Hemisphere-Project/FarAway/Arduino/Full-ESP32-pio/src/Pinout.txt

MOTOR
PUL --- 13
DIR --- 12
EN --- 14

RED LED
Data --- 27

I2C
SCL --- 33
SDA --- 32

SK
Data --- 4

AUDIO
PWM --- 22
