Hemisphere-Project/FarAway/Plans/Casing/Débit.rtf

Panneau CP peuplier 2520 x 1850 ép 15mm
—> 2 panneaux

Bas
3224 x 694
2520 x 694 + 704 x 694

Haut
3224 x 694
2520 x 694 + 704 x 694

Left
3224 x 400
2520 x 400 + 704 x 400

Right
3224 x 400
2520 x 400 + 704 x 400

Av
610 x 400

Arr
610 x 400

TASSEAUX

3224 —4 (L,R)
280 — 12 (L,R,Av,Arr)
610 — 4 (Av,Arr)
490 — 4 (Av,Arr,Top)
3140 — 2 (Top)

Tasseau raboté Pin 27 x 60 L4,8m
—> 6 Tasseaux
