Hemisphere-Project/FarAway/Plans_Cablage/Cablage.pdf

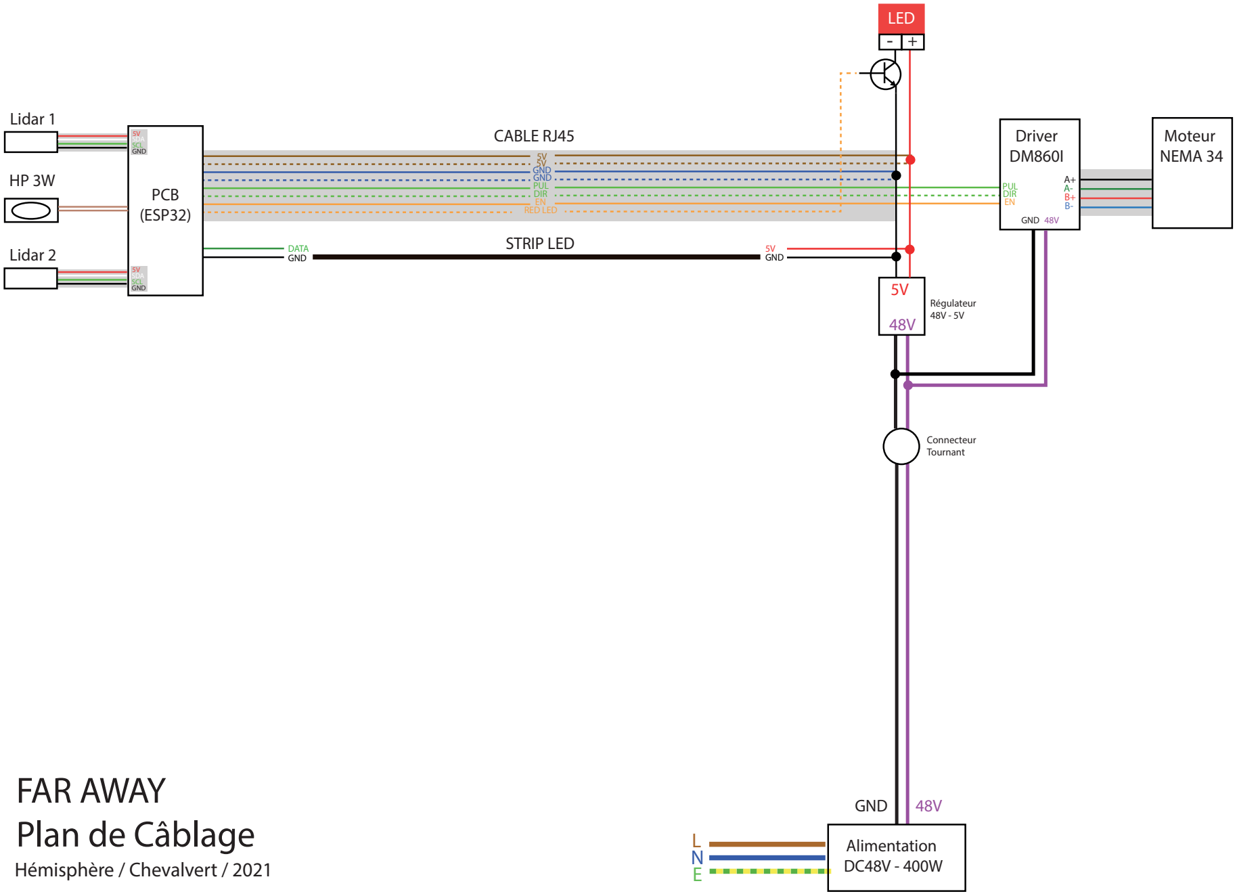
[picture p1: figure]
GND; GND DATA; 5V GND; GND PUL DIR EN RED LED; STRIP LED; Régulateur 48V - 5V; Connecteur Tournant; Driver DM860I; LED; Alimentation DC48V - 400W; Moteur NEMA 34; GND 48V; CABLE RJ45; FAR AWAY Plan de Câblage; Hémisphère / Chevalvert / 2021; Lidar 1; PCB (ESP32); PUL DIR EN; 5V SDA SCL GND; Lidar 2; SDA SCL GND
