Hemisphere-Project/FarAway/Docs/Far Away V2.pdf

Far away,

# Constellation 2021

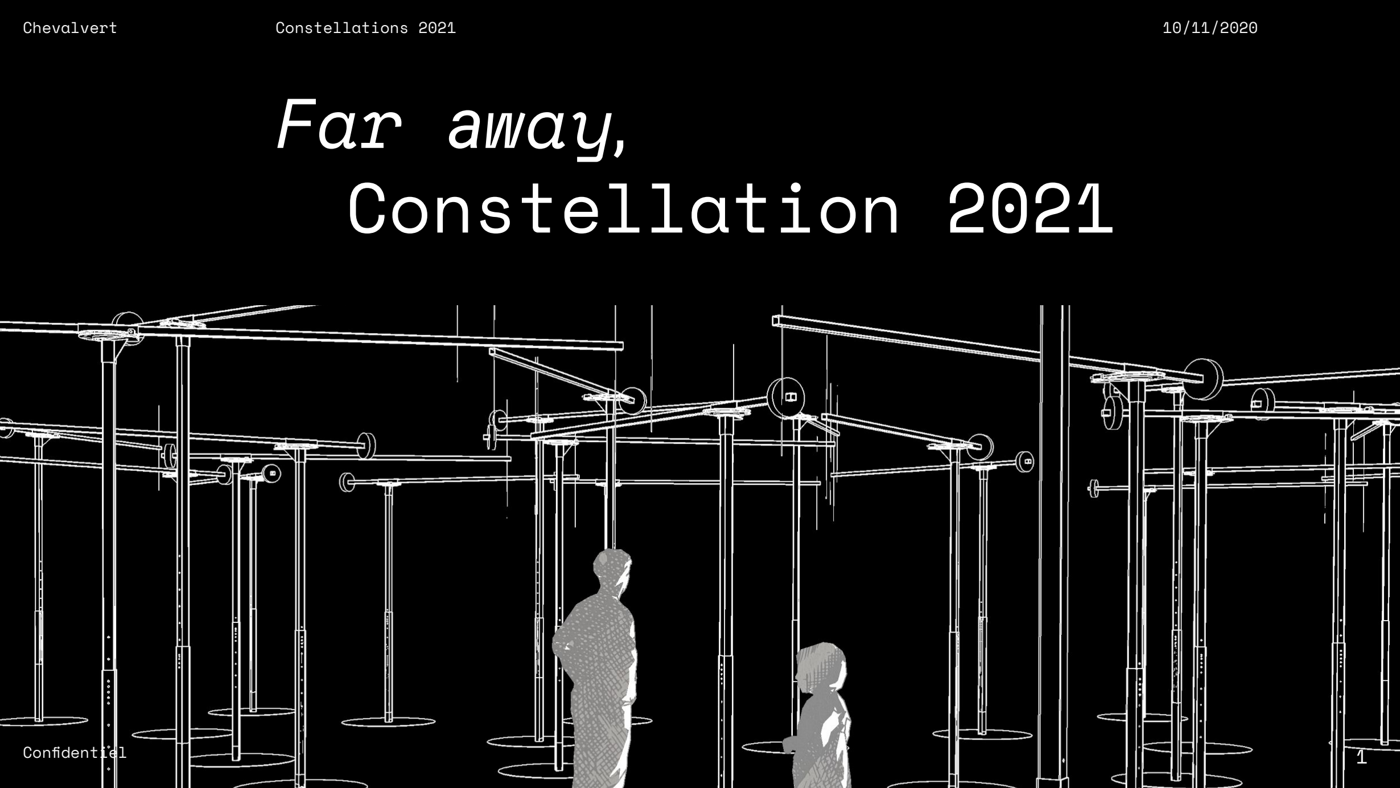
[picture p2: page 1]

10/11/2020

Confidentiel | 1
Chevalvert | Constellations 2021

# 1. Ré-enchanter la pointe Fabert en imaginant une installation

phare.

# 2. Un réseau lumineux inscrit entre deux des bras de la Moselle, aux

flux de l’eau et de la végétation.
3. Un signe lumière en mouvement,

# vivant, impulsé par l’activité des visiteurs et transmis de phare en

phare.

Chevalvert | Constellations 2021 | 10/11/2020

## Références et inspirations

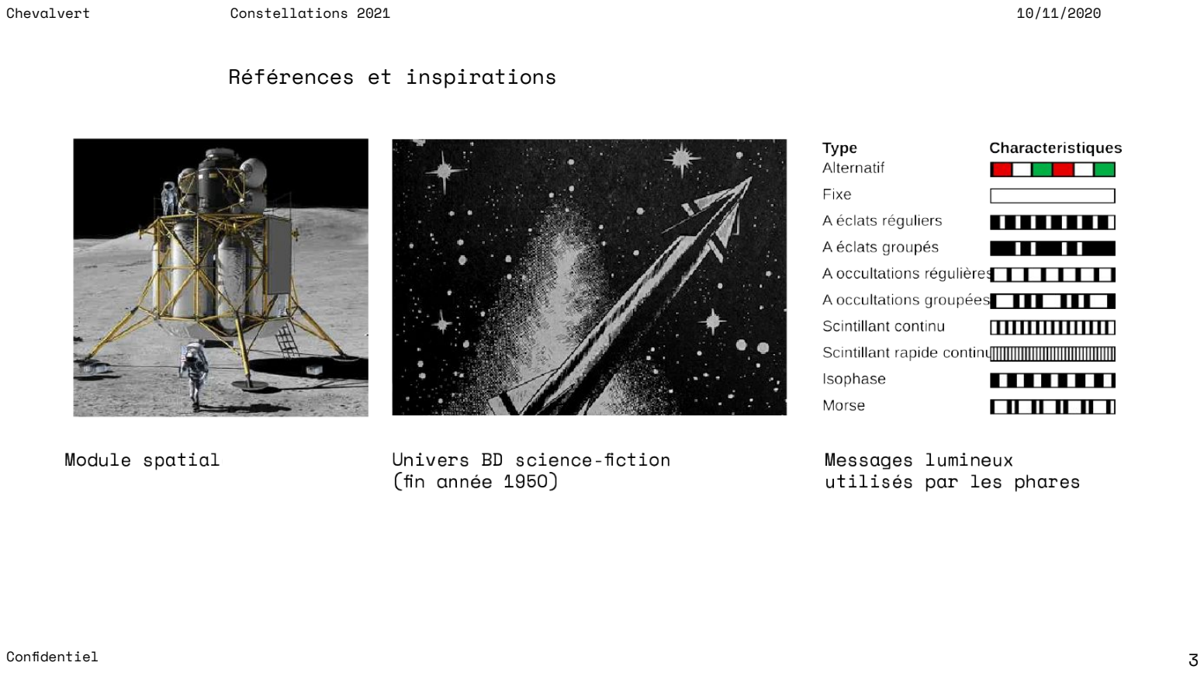
[picture p3: page 3]
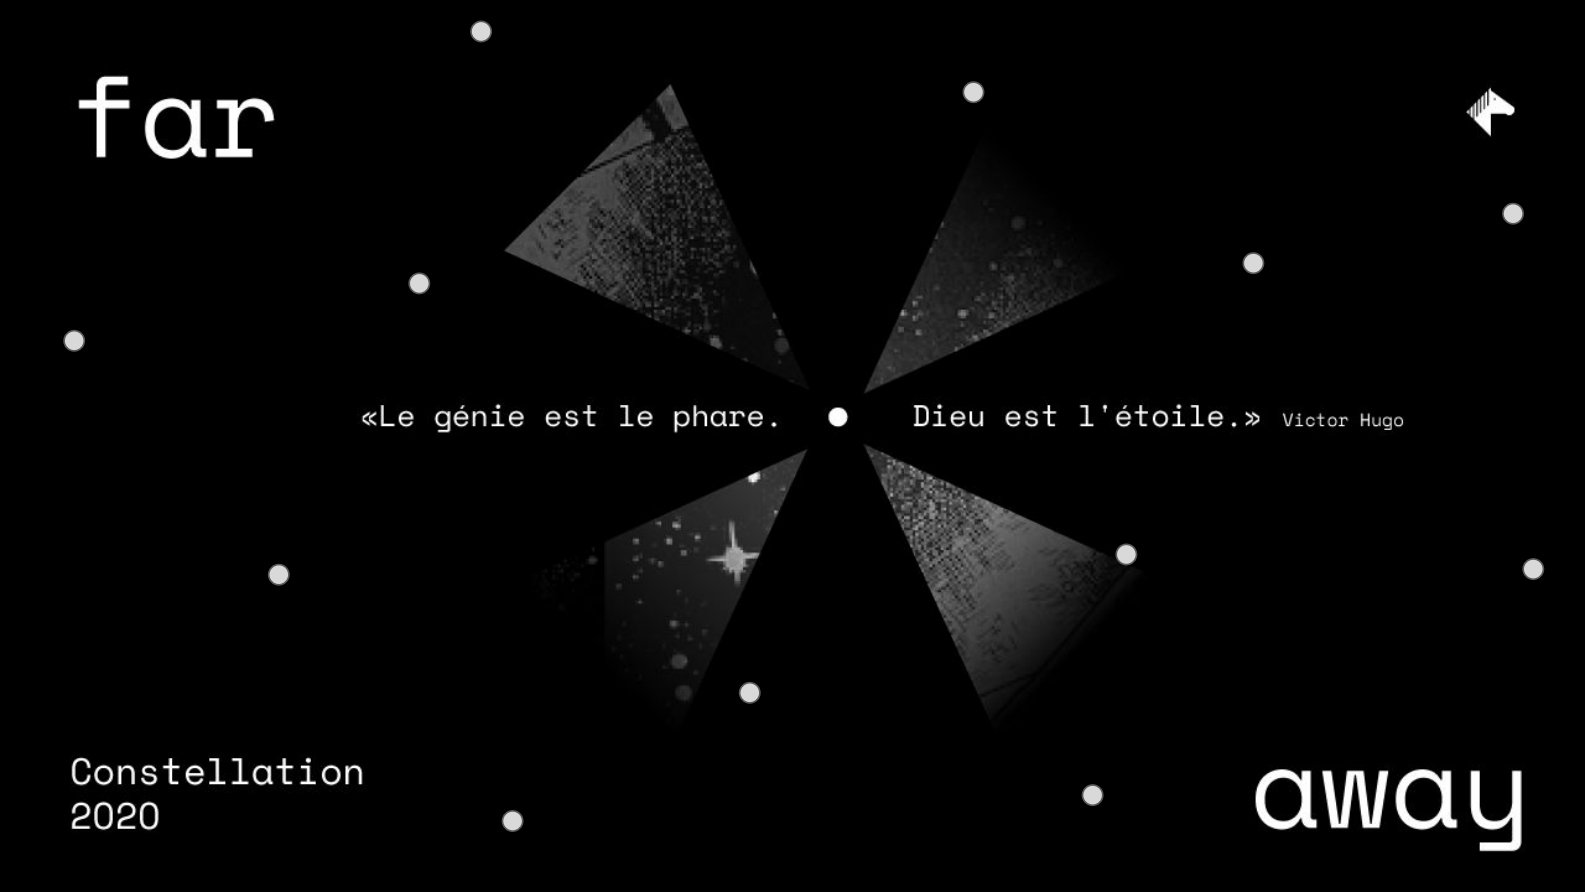
[picture p4: page 4]

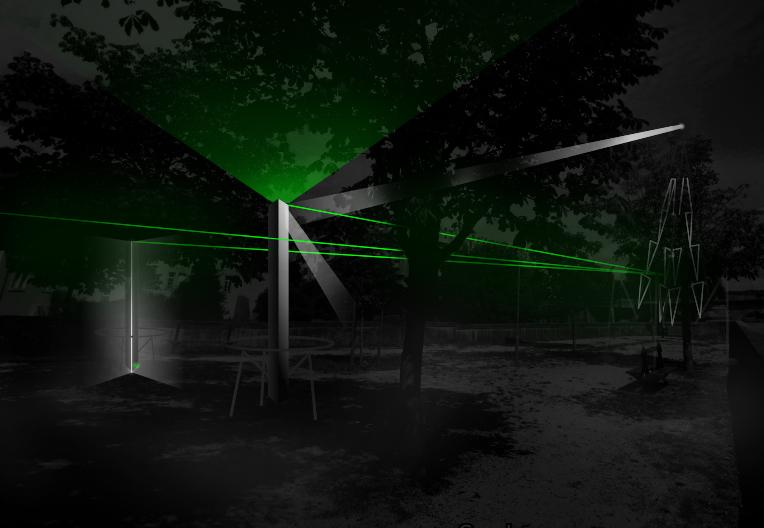
[picture p5: figure]

Version proposée
à l’origine.

## Far Away est une installation contemplative et immersive

autour des notions d’espace, de temps et de lumière.

L’installation se compose d’un module phare multiplié,

## construisant un réseau au sein duquel des signaux lumineux

naissent, se déplacent et meurent.

## La présence du visiteur éveille le phare qui se met à produire de la lumière et à tourner, contactant ainsi ses voisins les plus proches, propageant à la fois son éveil et

son signal lumineux.

## Ce signal ne vit que dans le mouvement, se déplaçant entre

les phares, créant des phénomènes d’écho, de rémanence,

## croisant parfois d’autres signaux, eux-mêmes générés par l’activité d’autres promeneurs à d’autres endroits du

réseau.

Version évoluée

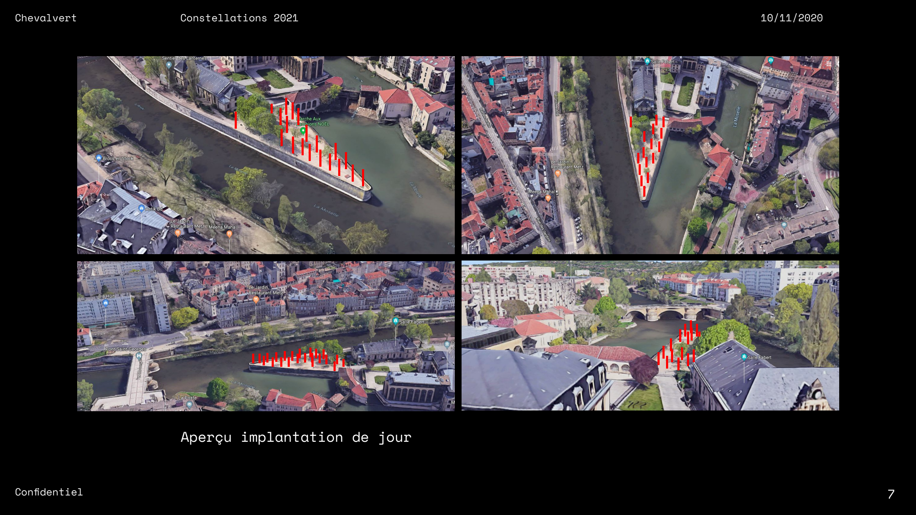
[picture p6: page 7]

## Aperçu implantation de jour

# Barre LED

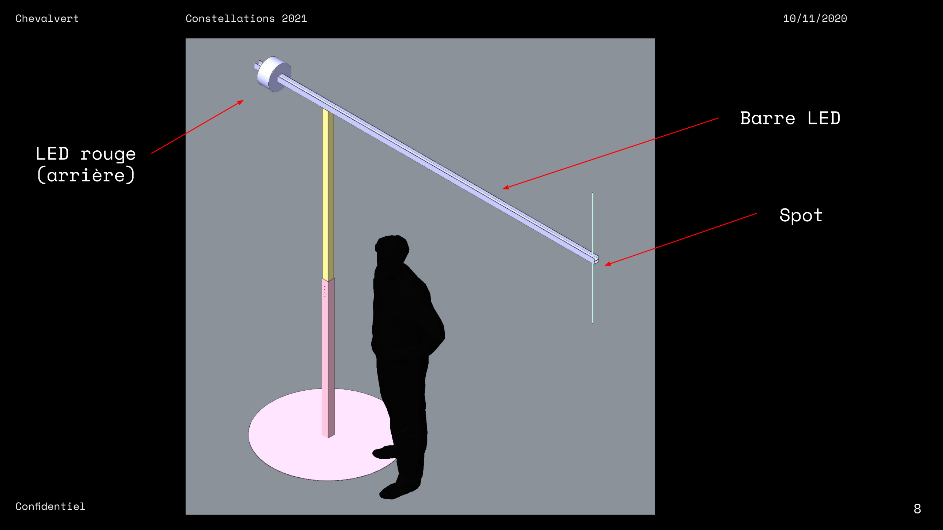
[picture p7: page 8]

# Spot

# LED rouge (arrière)

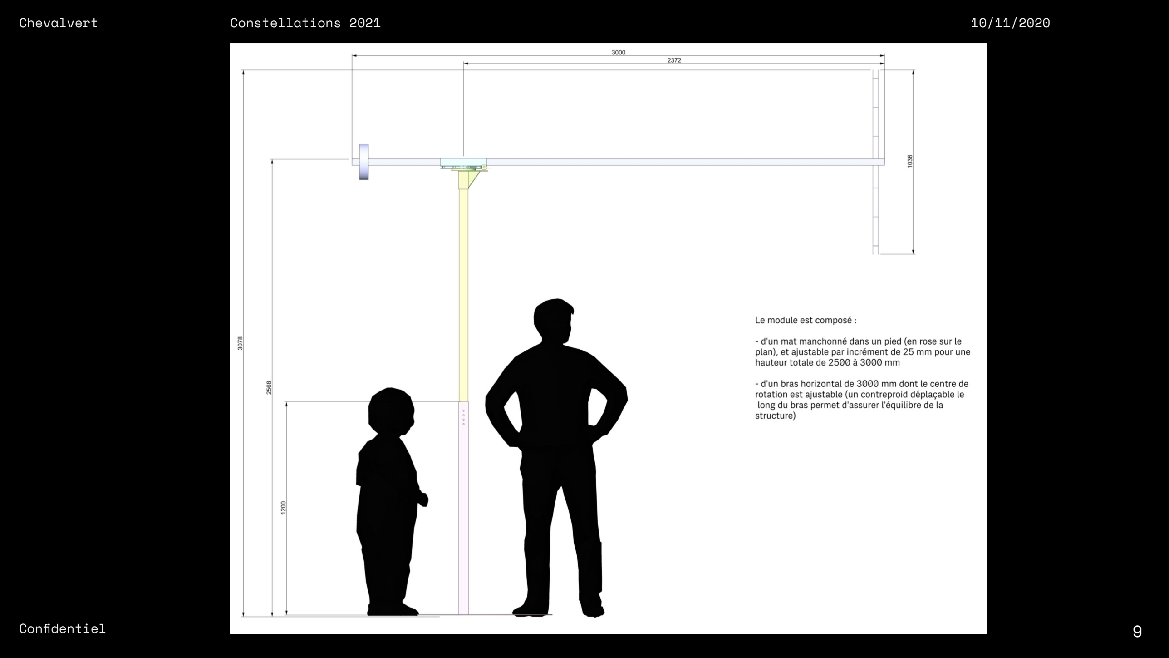
[picture p8: page 9]
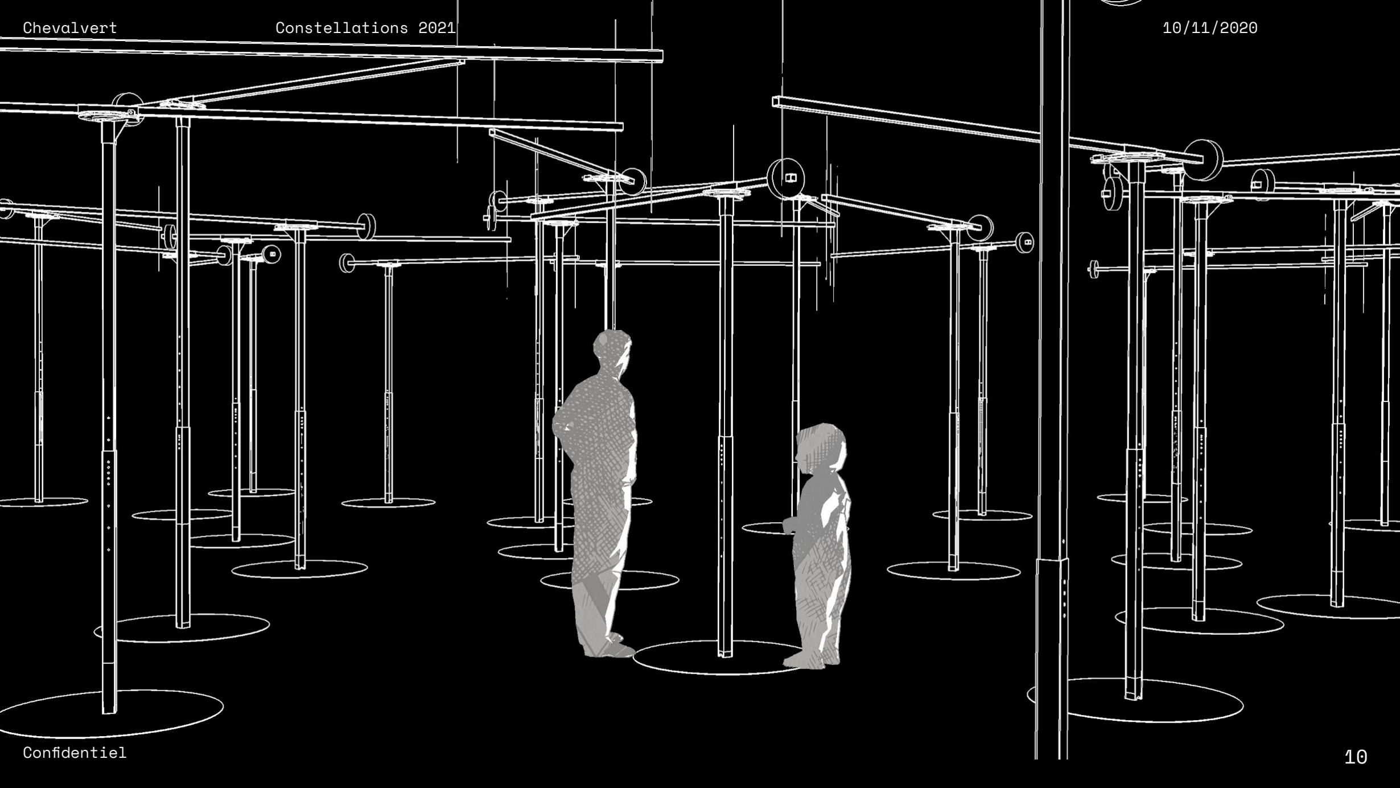
[picture p9: page 10]
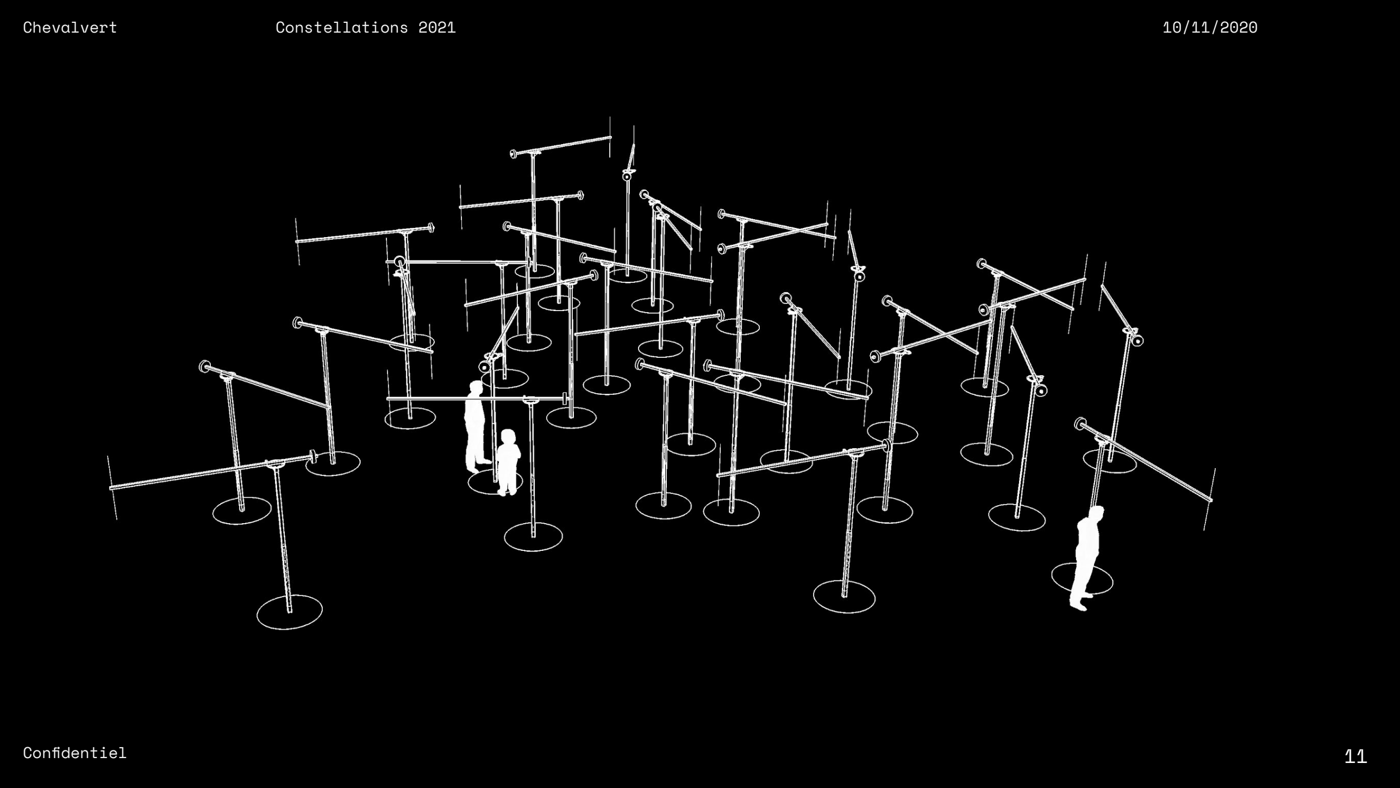
[picture p10: page 11]

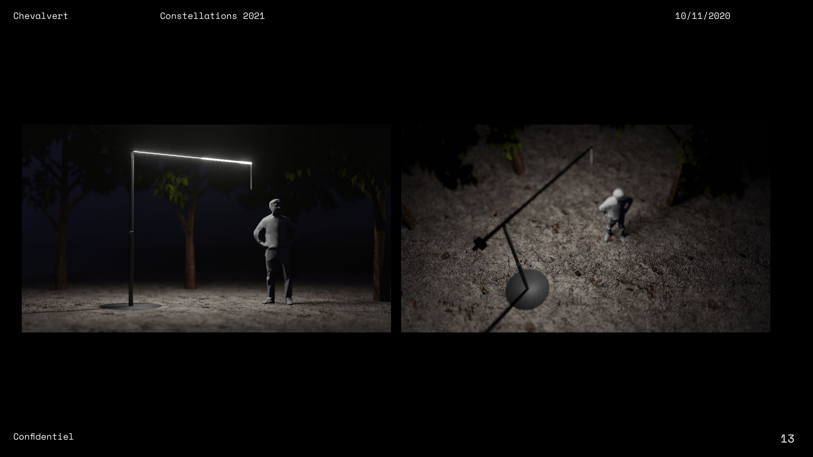
[picture p11: page 13]
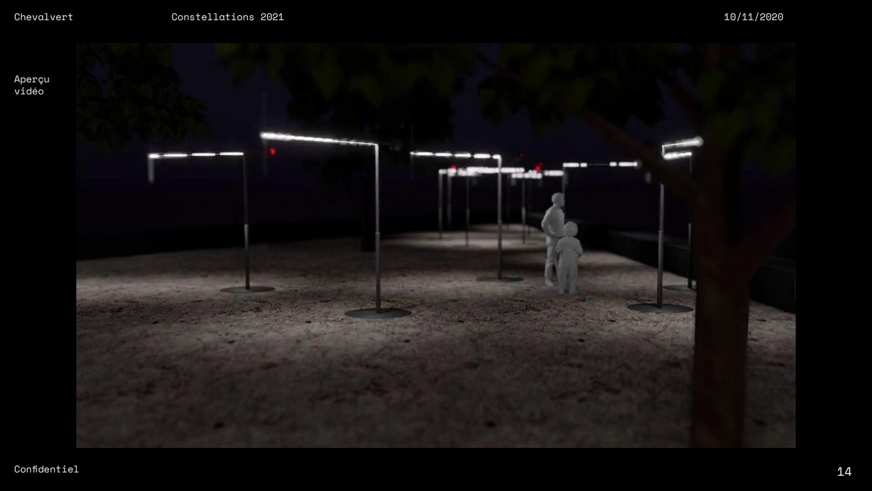
[picture p12: page 14]

Aperçu
vidéo

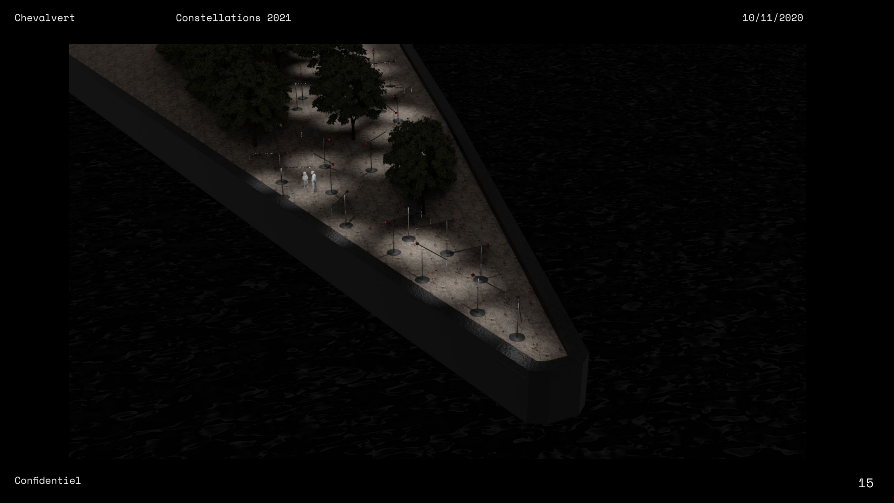
[picture p13: page 15]
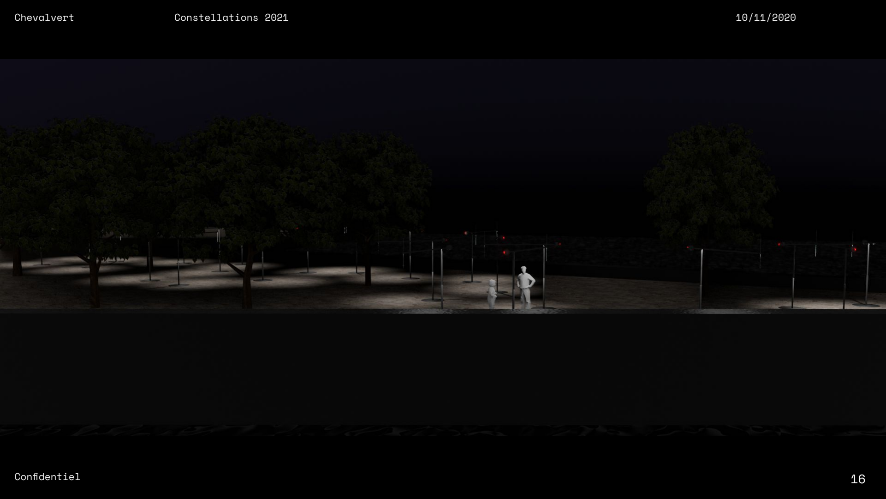
[picture p14: page 16]
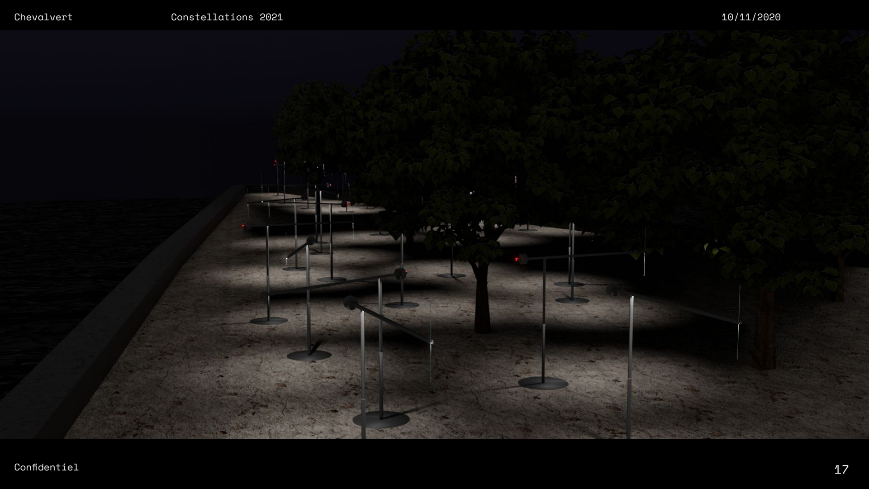
[picture p15: page 17]
