Hemisphere-Project/FarAway/Plans/pièces/Boitier avant (perçage)/Boitier avant.dxf

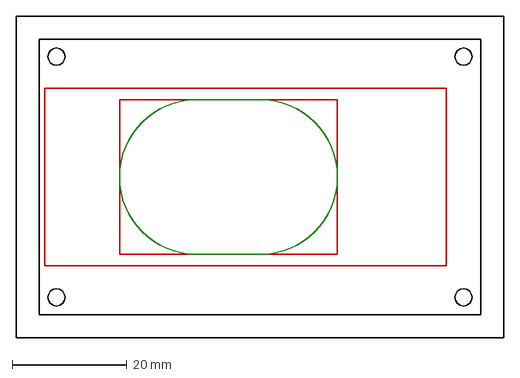
[picture p16: CAD file, 2021-05-27]
Plans/pièces/Boitier avant (perçage)/Boitier avant.dxf
85.0 x 56.0 mm
