Hemisphere-Project/FarAway/Plans/pièces/Laser PROD/Gousset/Gousset.stp

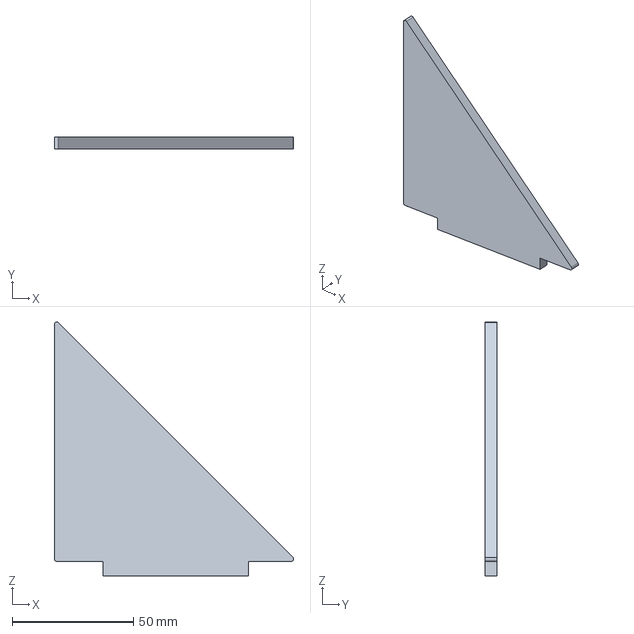
[picture p17: CAD file, 2021-04-19]
Plans/pièces/Laser PROD/Gousset/Gousset.stp
98.6 x 5.00 x 104.6 mm
