Hemisphere-Project/FarAway/Plans/pièces/Laser PROD/Platine Fixation Mat/Platine Fixation Mat.stp

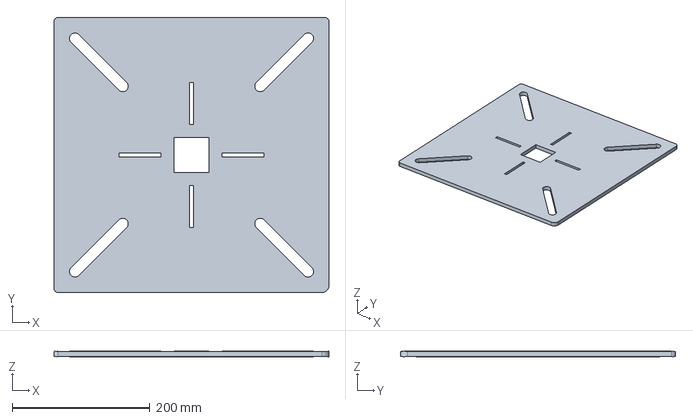
[picture p18: CAD file, 2021-04-19]
Plans/pièces/Laser PROD/Platine Fixation Mat/Platine Fixation Mat.stp
400.0 x 400.0 x 8.00 mm
