Hemisphere-Project/FarAway/Plans/pièces/Laser PROD/Platine Fixation Moteur/Platine Fixation Moteur.stp

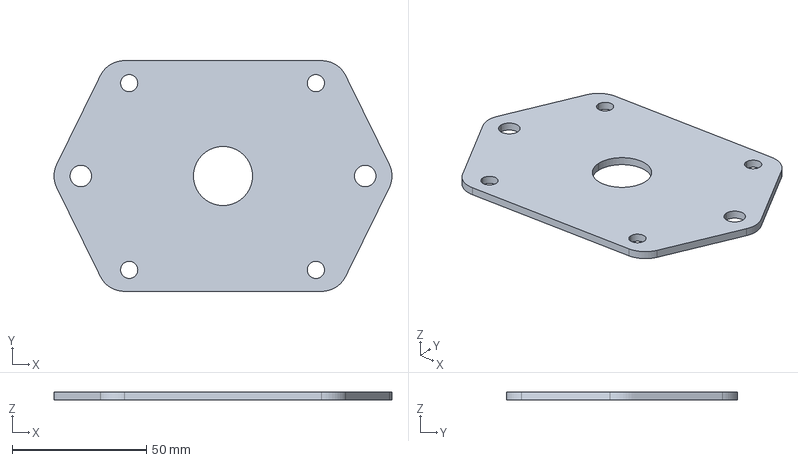
[picture p19: CAD file, 2021-04-19]
Plans/pièces/Laser PROD/Platine Fixation Moteur/Platine Fixation Moteur.stp
126.0 x 86.0 x 3.00 mm
