Hemisphere-Project/FarAway/Plans/pièces/Laser PROD/Platine Jonction Pivot 1/Platine Jonction Pivot 1.stp

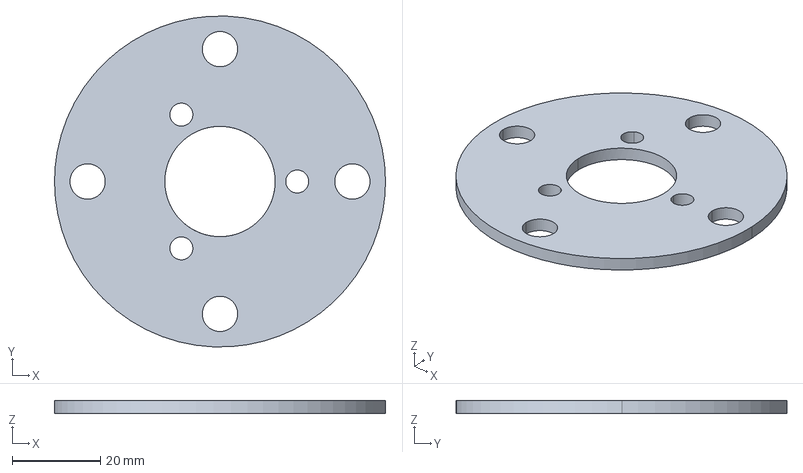
[picture p20: CAD file, 2021-04-19]
Plans/pièces/Laser PROD/Platine Jonction Pivot 1/Platine Jonction Pivot 1.stp
75.0 x 74.9 x 3.00 mm
