Hemisphere-Project/FarAway/Plans/pièces/Laser PROD/Platine Jonction Pivot 2/Platine Jonction Pivot 2.stp

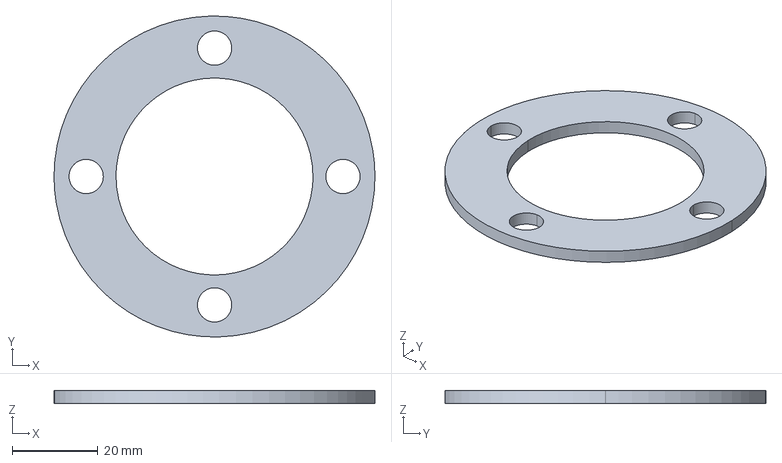
[picture p21: CAD file, 2021-04-19]
Plans/pièces/Laser PROD/Platine Jonction Pivot 2/Platine Jonction Pivot 2.stp
75.0 x 75.0 x 3.00 mm
