Hemisphere-Project/FarAway/Plans/pièces/Laser proto/Platine Jonction Pivot 2.dxf

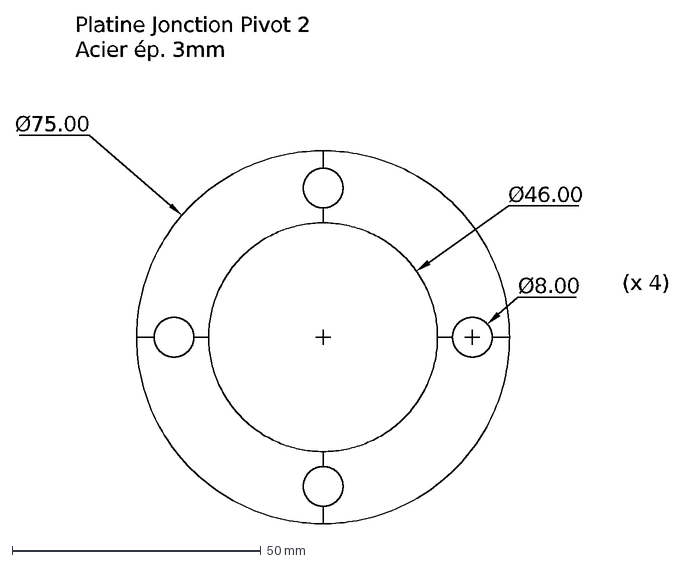
[picture p23: CAD file, 2021-03-10]
Plans/pièces/Laser proto/Platine Jonction Pivot 2.dxf
Platine Jonction Pivot 2 Acier ép. 3mm
Ø46.00
(x 4)
Ø8.00
Ø75.00
