Hemisphere-Project/FarAway/Plans/pièces/Platine Lidar/Platine Lidar.dxf

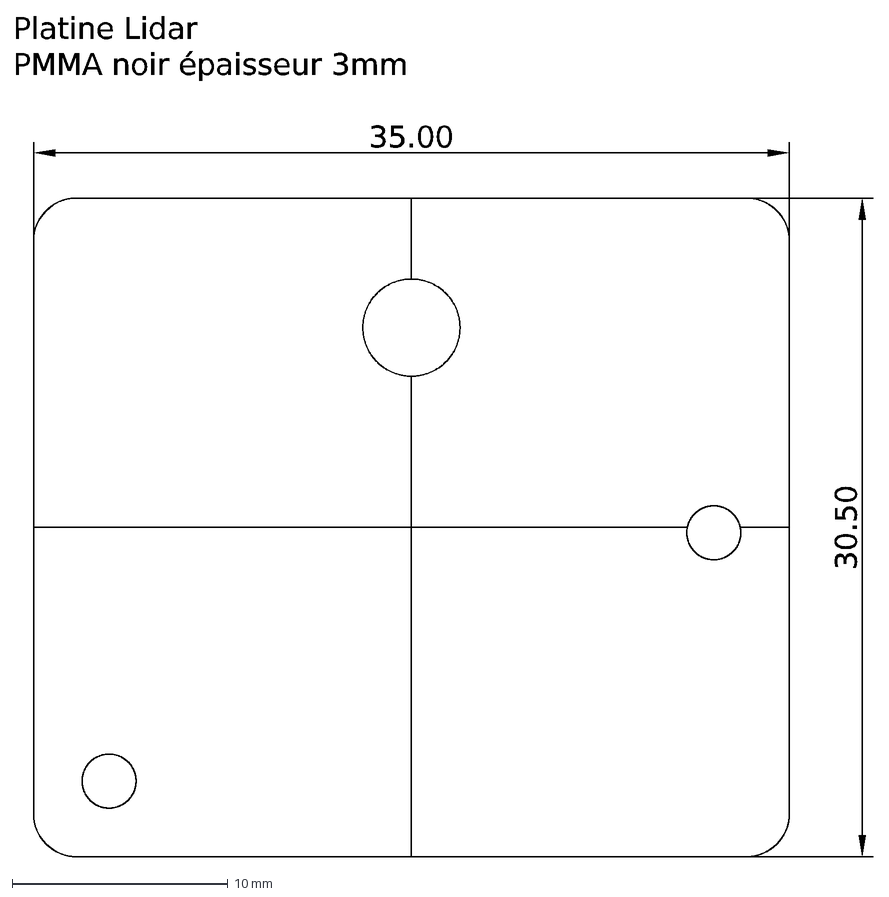
[picture p24: CAD file, 2021-04-19]
Plans/pièces/Platine Lidar/Platine Lidar.dxf
Platine Lidar PMMA noir épaisseur 3mm
30.50
35.00
