Hemisphere-Project/FarAway/Plans/pièces/Profilé/Motedis Profile 30x30 B-Type slot 8.stp

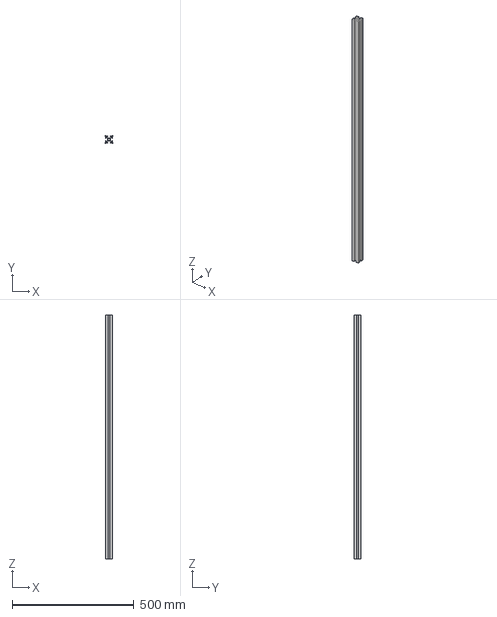
[picture p25: CAD file, 2021-03-10]
Plans/pièces/Profilé/Motedis Profile 30x30 B-Type slot 8.stp
30.0 x 30.0 x 1000.0 mm
