Hemisphere-Project/FarAway/(list of files, cad)

Other CAD files:
Plans/2D/Far away - Plan.dwg
Plans/pièces/Tournage/proto/Poulie moteur.dwg
Plans/pièces/Tournage/proto/Entretoise fixation moteur.dwg
Plans/pièces/Tournage/proto/Poulie Pivot.dwg
Plans/Casing/Stockage_Case.3dm
Plans/pièces/Boitier avant (perçage)/Boitier avant.3dm
Plans/pièces/Boitier driver (perçage)/Boitier Driver.3dm
Plans/pièces/Laser PROD/Gousset/Gousset.3dm
Plans/pièces/Laser PROD/Gousset/Gousset.dwg
Plans/pièces/Laser PROD/Gousset/Gousset.dxf
Plans/pièces/Laser PROD/Platine Fixation Mat/Platine Fixation Mat.3dm
Plans/pièces/Laser PROD/Platine Fixation Mat/Platine Fixation Mat.dwg
Plans/pièces/Laser PROD/Platine Fixation Mat/Platine Fixation Mat.dxf
Plans/pièces/Laser PROD/Platine Fixation Moteur/Platine Fixation Moteur.3dm
Plans/pièces/Laser PROD/Platine Fixation Moteur/Platine Fixation Moteur.dwg
Plans/pièces/Laser PROD/Platine Fixation Moteur/Platine Fixation Moteur.dxf
Plans/pièces/Laser PROD/Platine Jonction Pivot 1/Platine Jonction Pivot 1.3dm
Plans/pièces/Laser PROD/Platine Jonction Pivot 1/Platine Jonction Pivot 1.dwg
Plans/pièces/Laser PROD/Platine Jonction Pivot 1/Platine Jonction Pivot 1.dxf
Plans/pièces/Laser PROD/Platine Jonction Pivot 2/Platine Jonction Pivot 2.3dm
Plans/pièces/Laser PROD/Platine Jonction Pivot 2/Platine Jonction Pivot 2.dwg
Plans/pièces/Laser PROD/Platine Jonction Pivot 3/Platine Jonction Pivot 3.3dm
Plans/pièces/Laser PROD/Platine Jonction Pivot 3/Platine Jonction Pivot 3.dwg
Plans/pièces/Laser PROD/Platine Jonction Pivot 3/Platine Jonction Pivot 3.dxf
Plans/pièces/Platine Lidar/Platine Lidar & vis.3dm
Plans/pièces/Platine Lidar/Platine Lidar.3dm
Plans/pièces/Tournage/proto/Entretoise fixation moteur.3dm
Plans/pièces/Tournage/proto/Poulie Pivot.3dm
Plans/pièces/Tournage/proto/Poulie moteur.3dm
