Hemisphere-Project/FarAway/Plans/pièces/Tournage/Far away - Plan fabrication - Poulie pivot.pdf

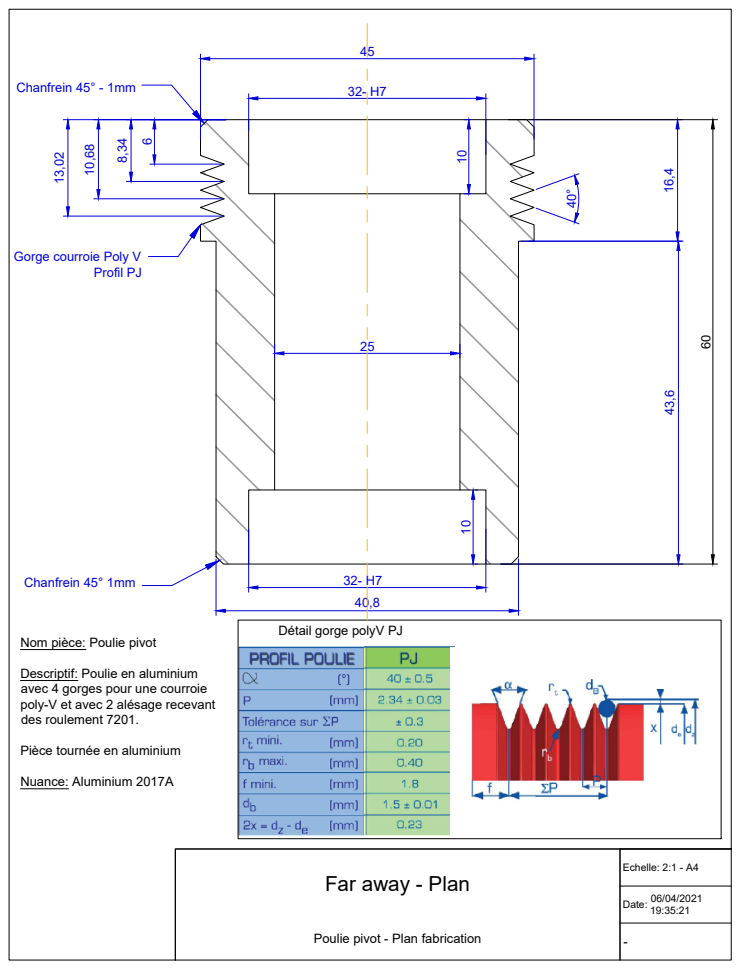
[picture p26: page 1]
Echelle: 2:1 - A4; Chanfrein 45° - 1mm; Chanfrein 45° 1mm; Profil PJ; Nuance: Aluminium 2017A

Gorge courroie Poly V

Détail gorge polyV PJ

Nom pièce: Poulie pivot

Descriptif: Poulie en aluminium
avec 4 gorges pour une courroie
poly-V et avec 2 alésage recevant
des roulement 7201.

Pièce tournée en aluminium

- Far away - Plan

Poulie pivot - Plan fabrication
