Hemisphere-Project/FarAway/Docs/MOTOR NEMA 34HE45-6004S.pdf

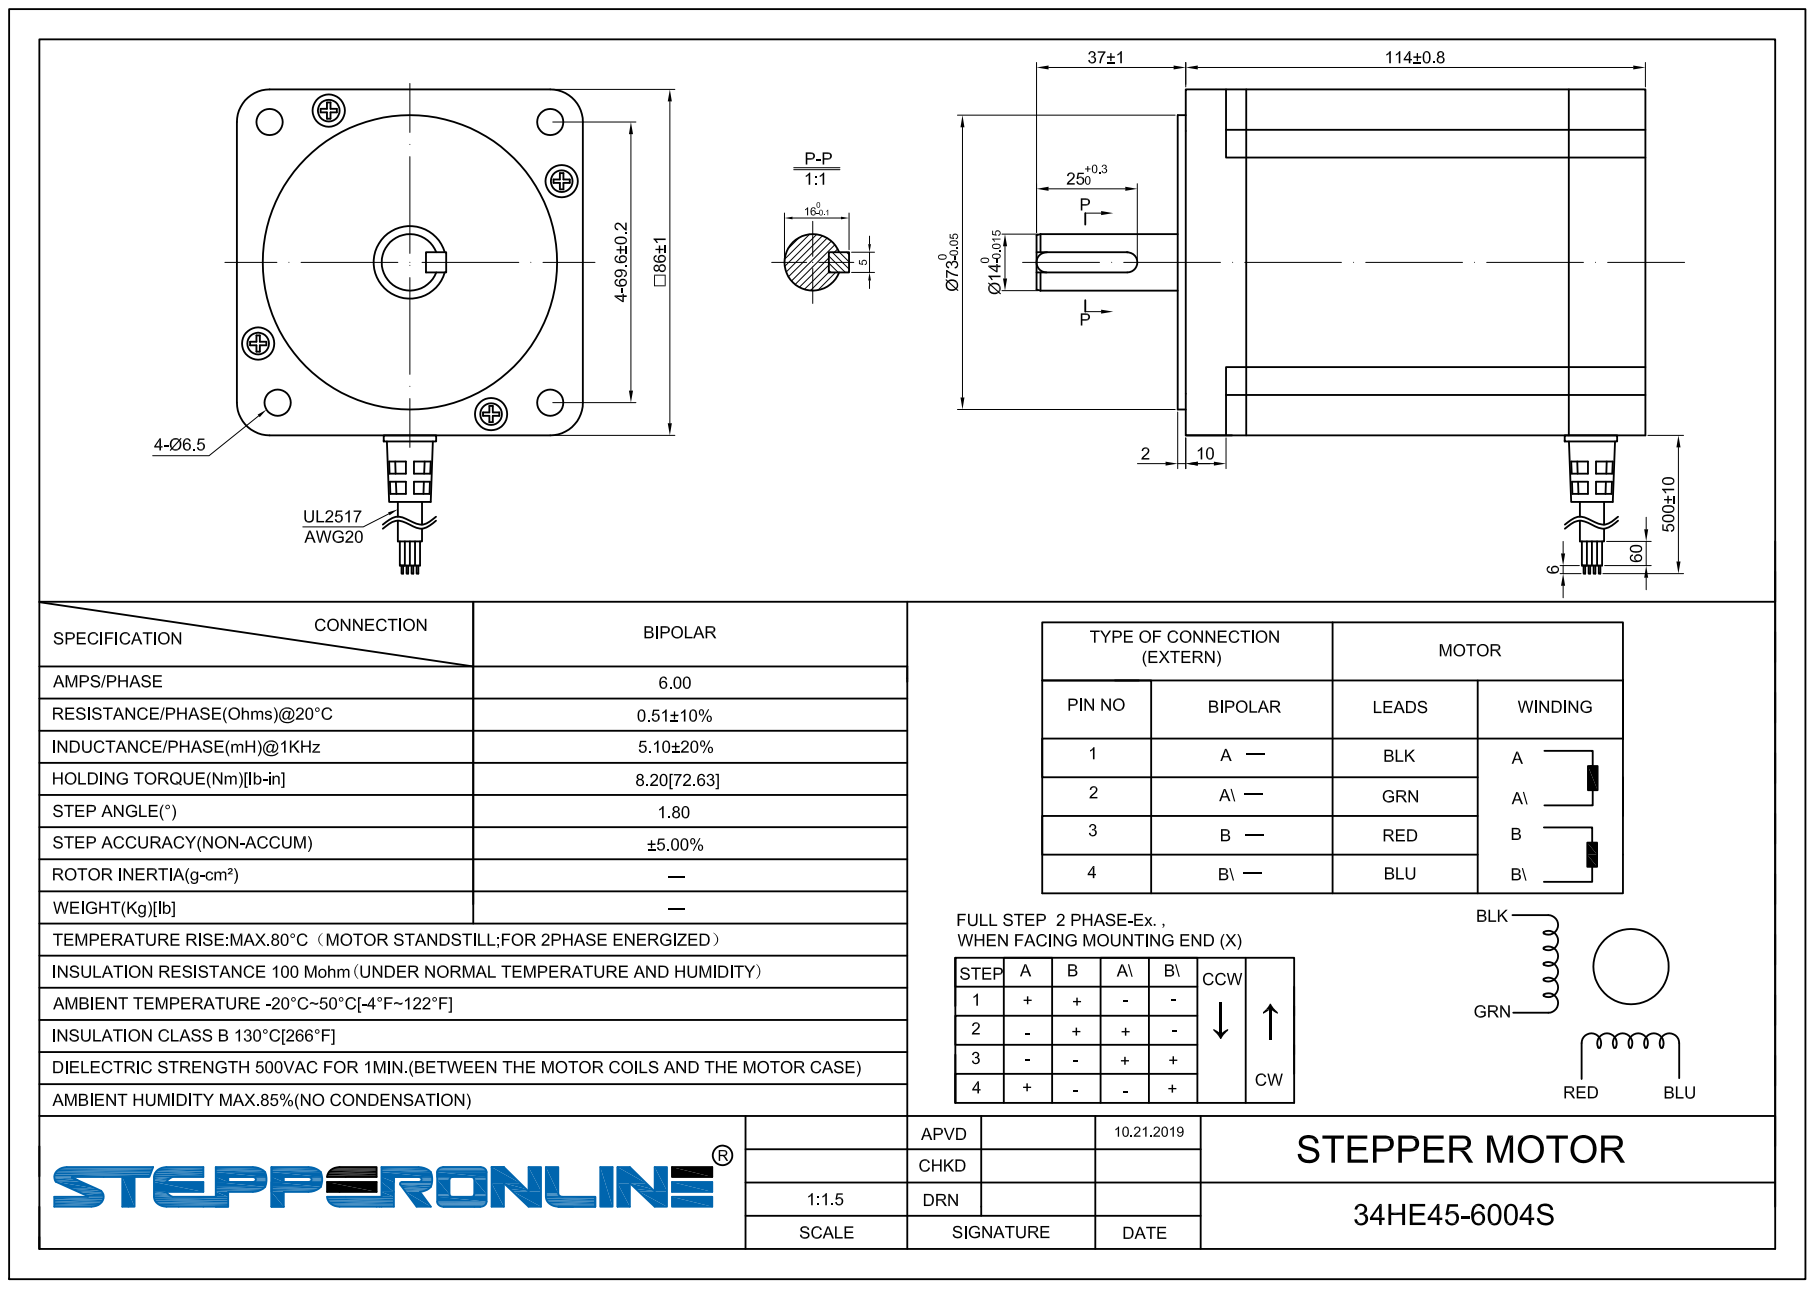
[picture p28: page 1]
