Hemisphere-Project/FarAway/Plans/Casing/Stockage_Case_débit.pdf

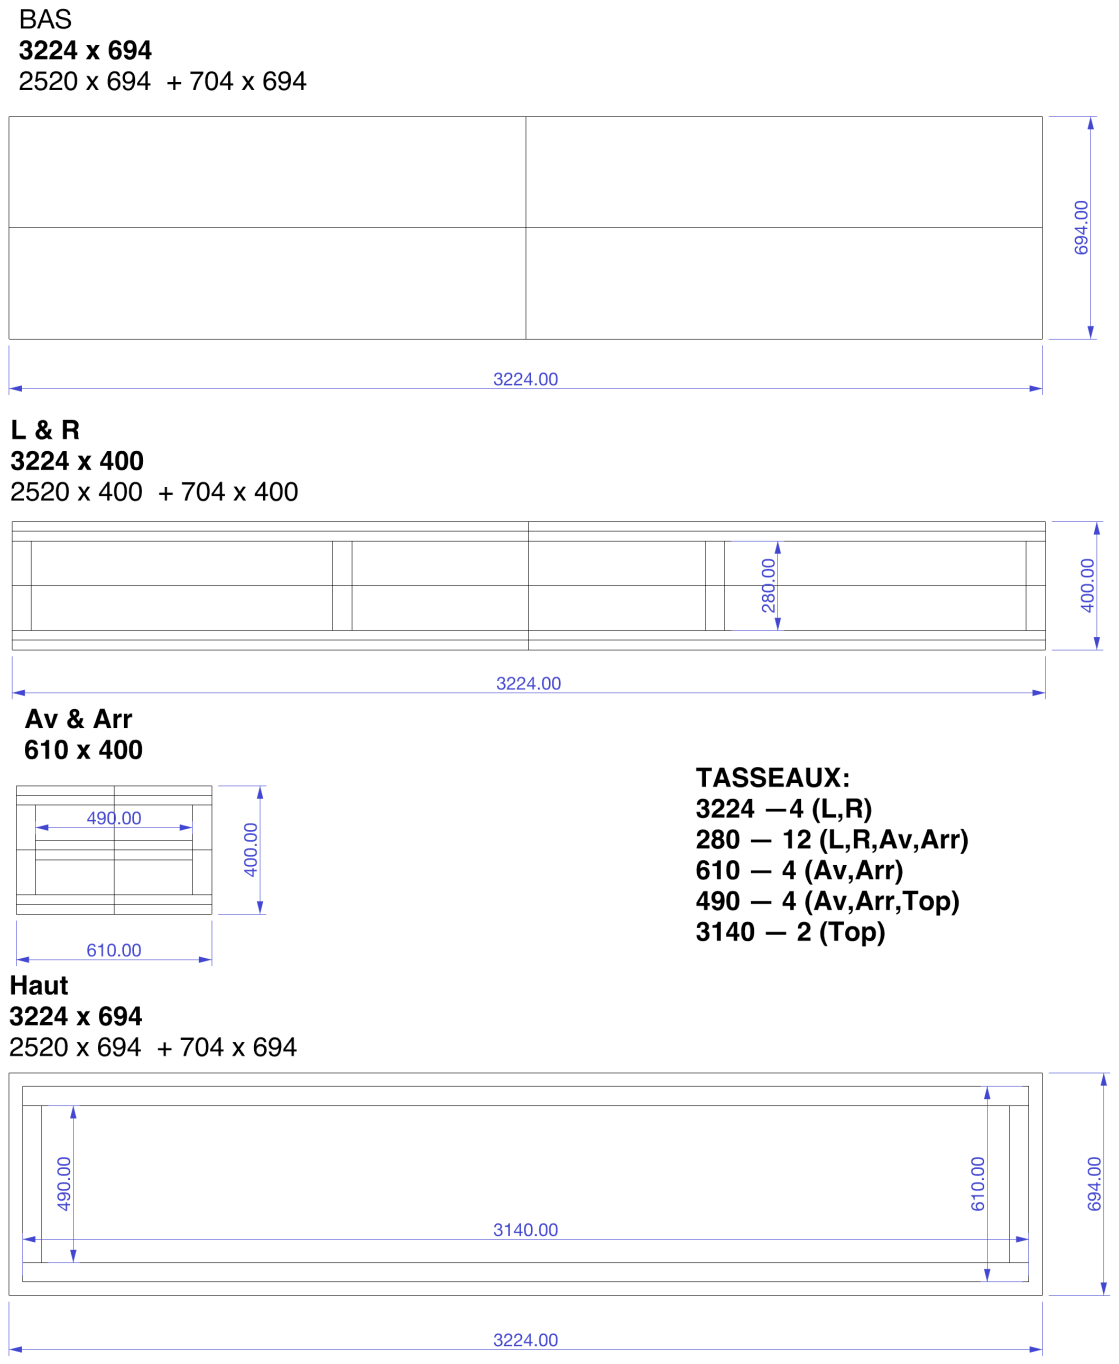
[picture p29: page 1]
