Hemisphere-Project/FarAway/Plans/pièces/Platine Lidar/Platine Lidar.pdf

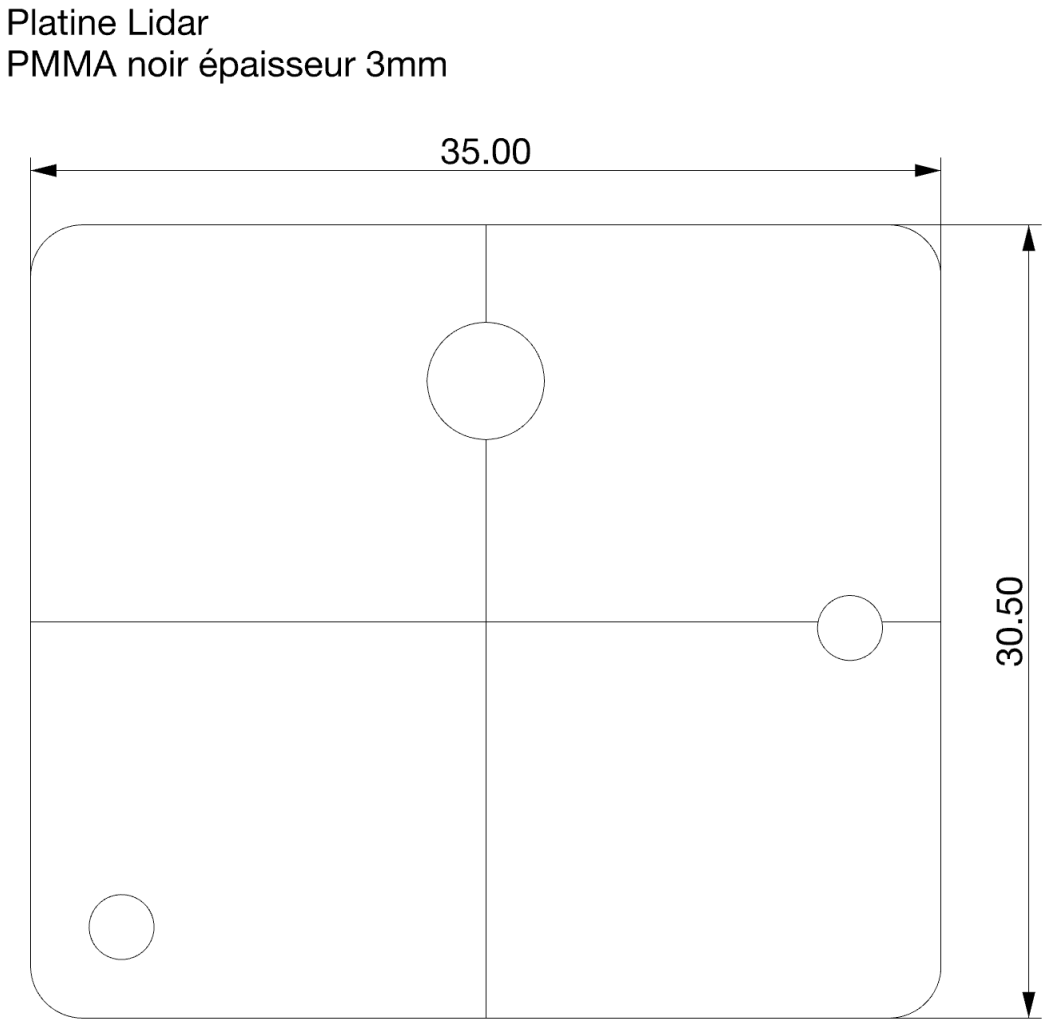
[picture p30: page 1]
