Hemisphere-Project/FarAway/Plans/pièces/Laser PROD/Gousset/Gousset.pdf

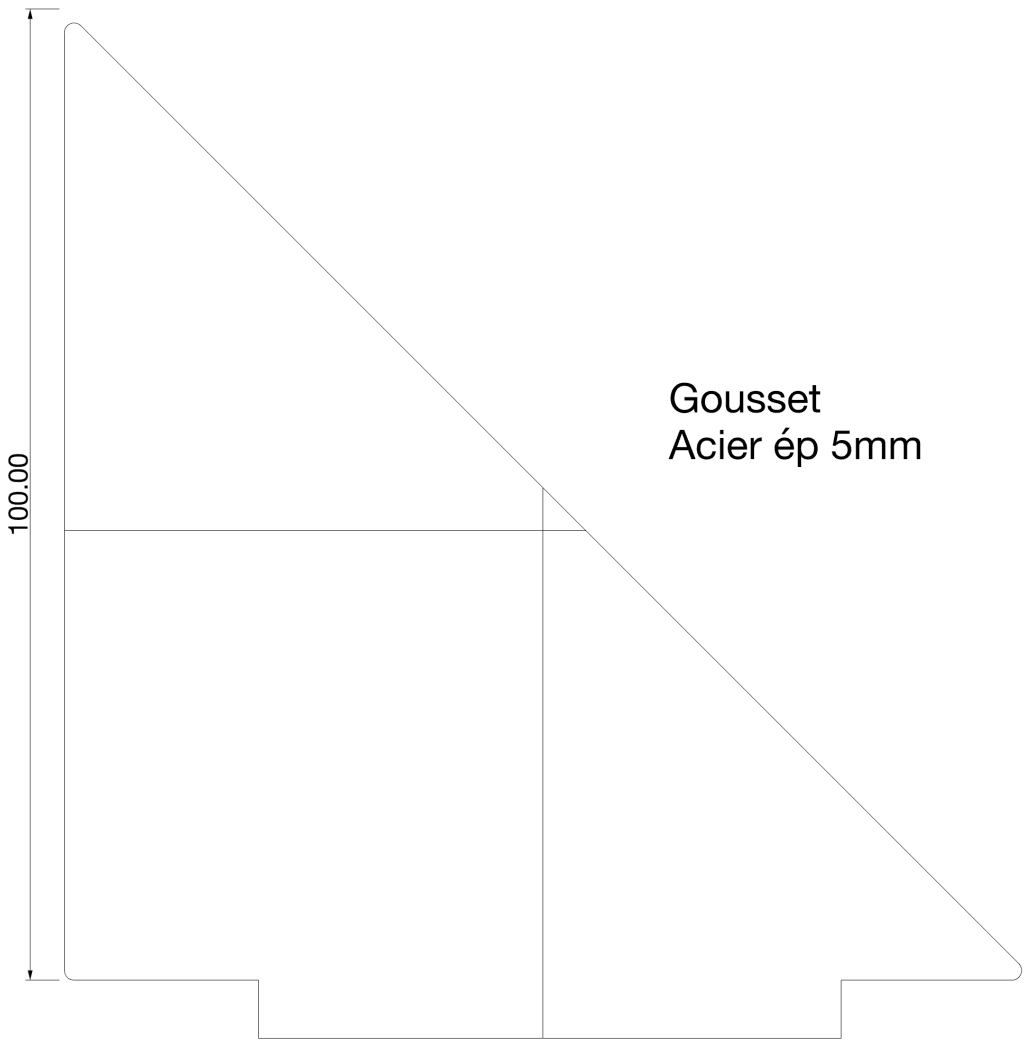
[picture p31: page 1]
