Hemisphere-Project/FarAway/Plans/pièces/Laser PROD/Platine Fixation Mat/Platine Fixation Mat.pdf

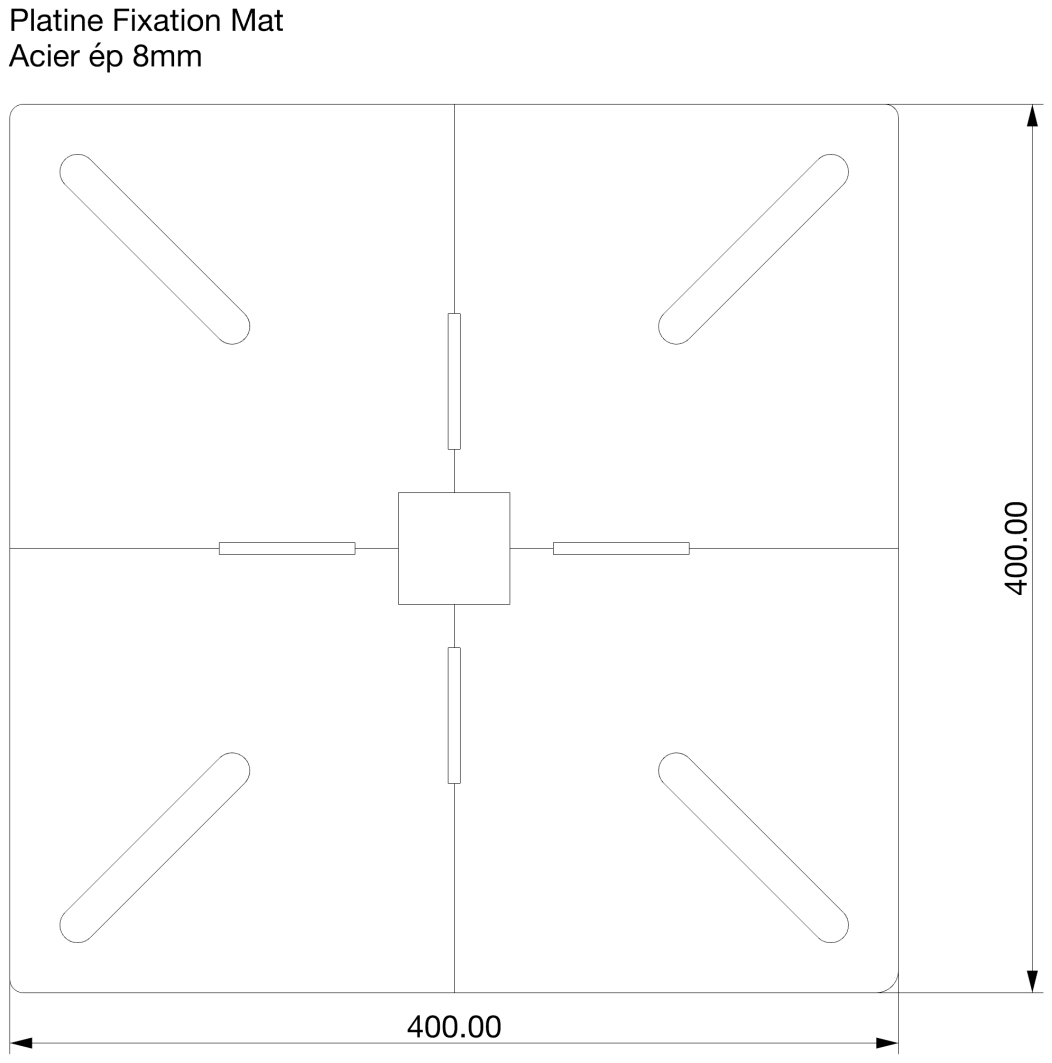
[picture p32: page 1]
