Hemisphere-Project/FarAway/Plans/pièces/Laser PROD/Platine Fixation Moteur/Platine Fixation Moteur.pdf

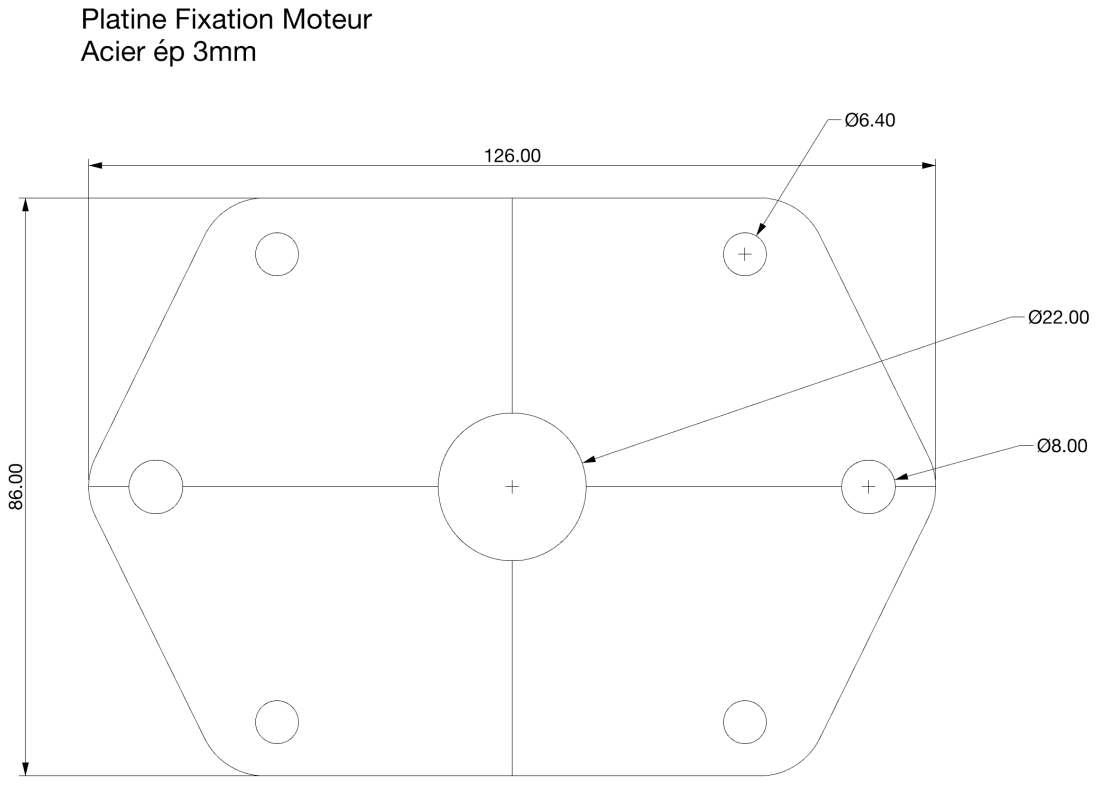
[picture p33: page 1]
