Hemisphere-Project/FarAway/Plans/pièces/Laser PROD/Platine Jonction Pivot 1/Platine Jonction Pivot 1.pdf

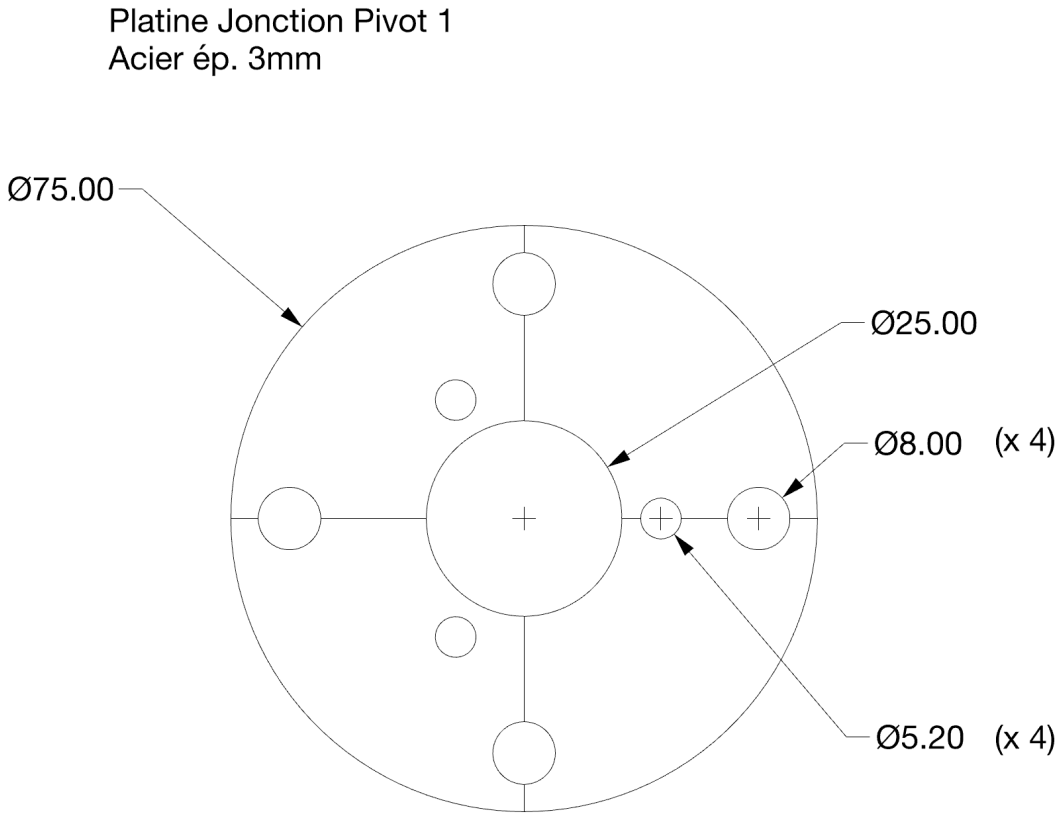
[picture p34: page 1]
