Hemisphere-Project/FarAway/Plans/pièces/Laser PROD/Platine Jonction Pivot 2/Platine Jonction Pivot 2.pdf

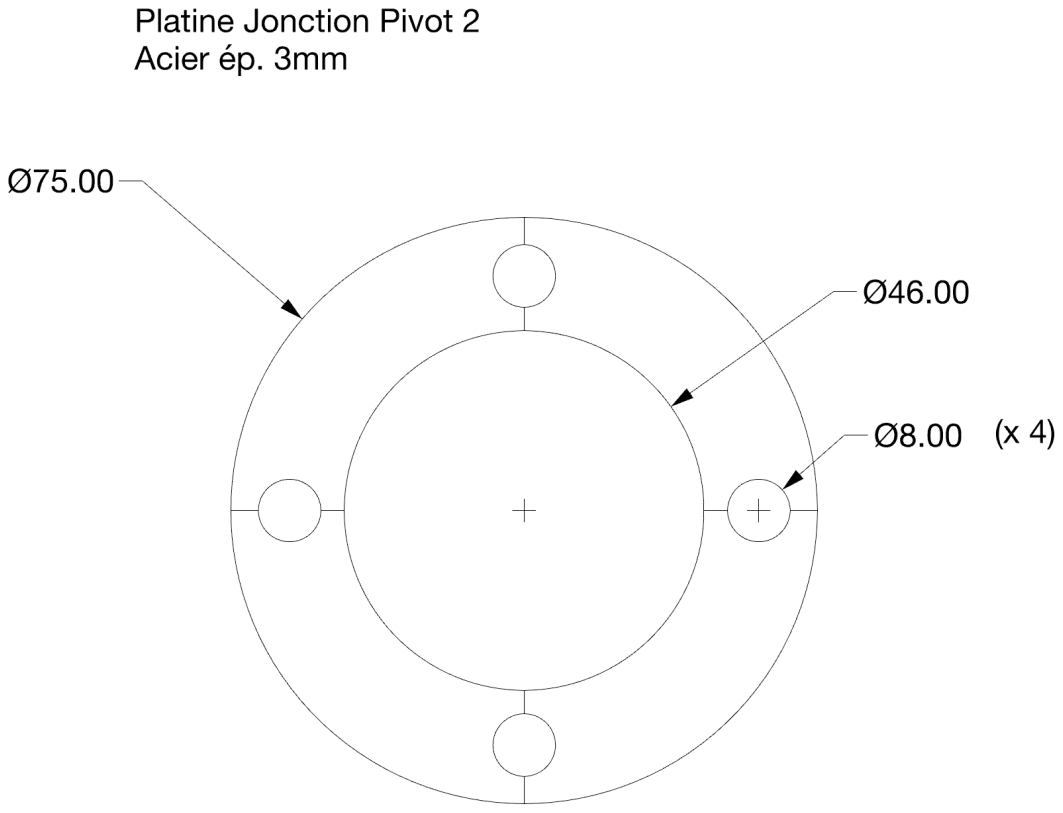
[picture p35: page 1]
