Hemisphere-Project/FarAway/Plans/pièces/Laser PROD/Platine Jonction Pivot 3/Platine Jonction Pivot 3.pdf

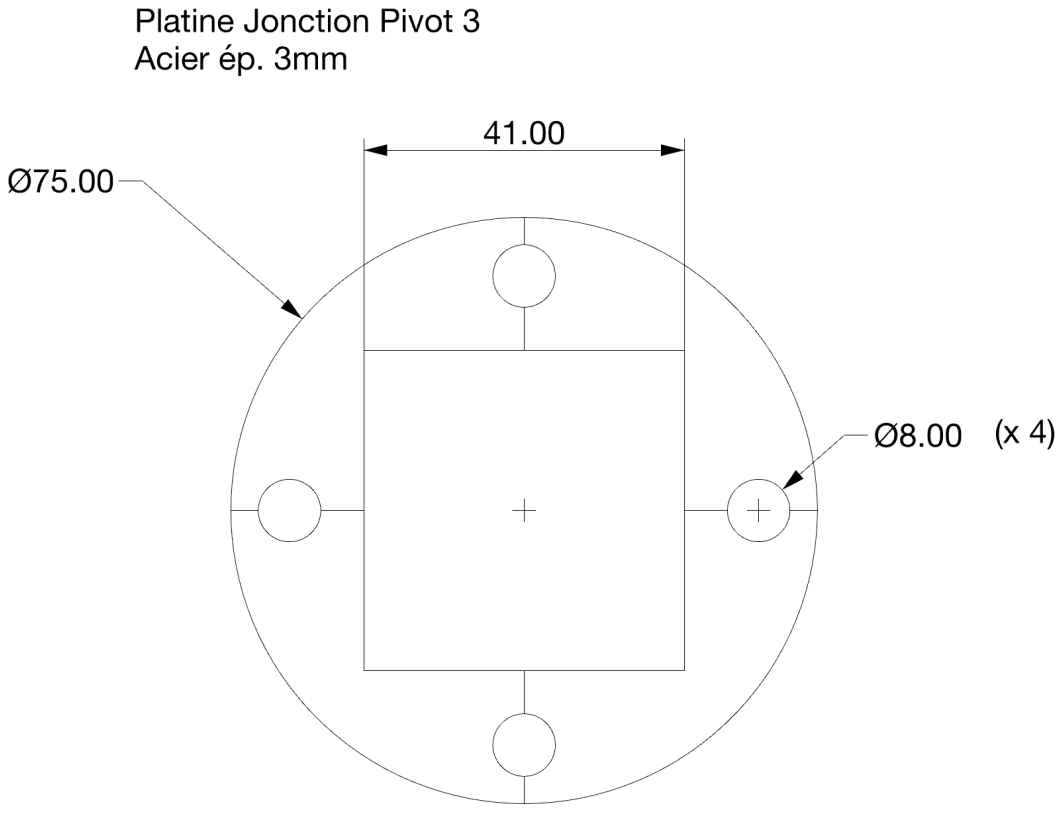
[picture p36: page 1]
