Hemisphere-Project/FarAway/Plans/pièces/Tournage/proto/Far away - Devis piece usinage.pdf

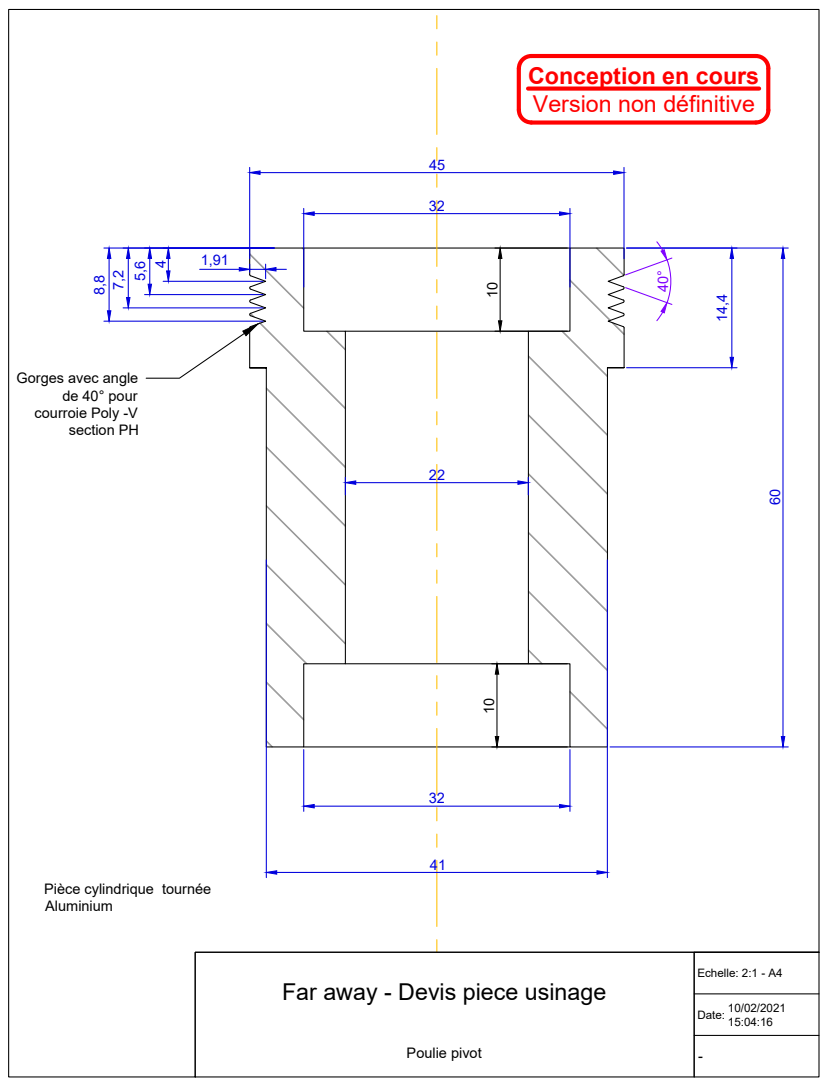
[picture p37: page 1]
Echelle: 2:1 - A4; Poulie pivot; de 40° pour courroie Poly -V section PH

Conception en cours
Version non définitive

Gorges avec angle

Pièce cylindrique tournée
Aluminium

- Far away - Devis piece usinage

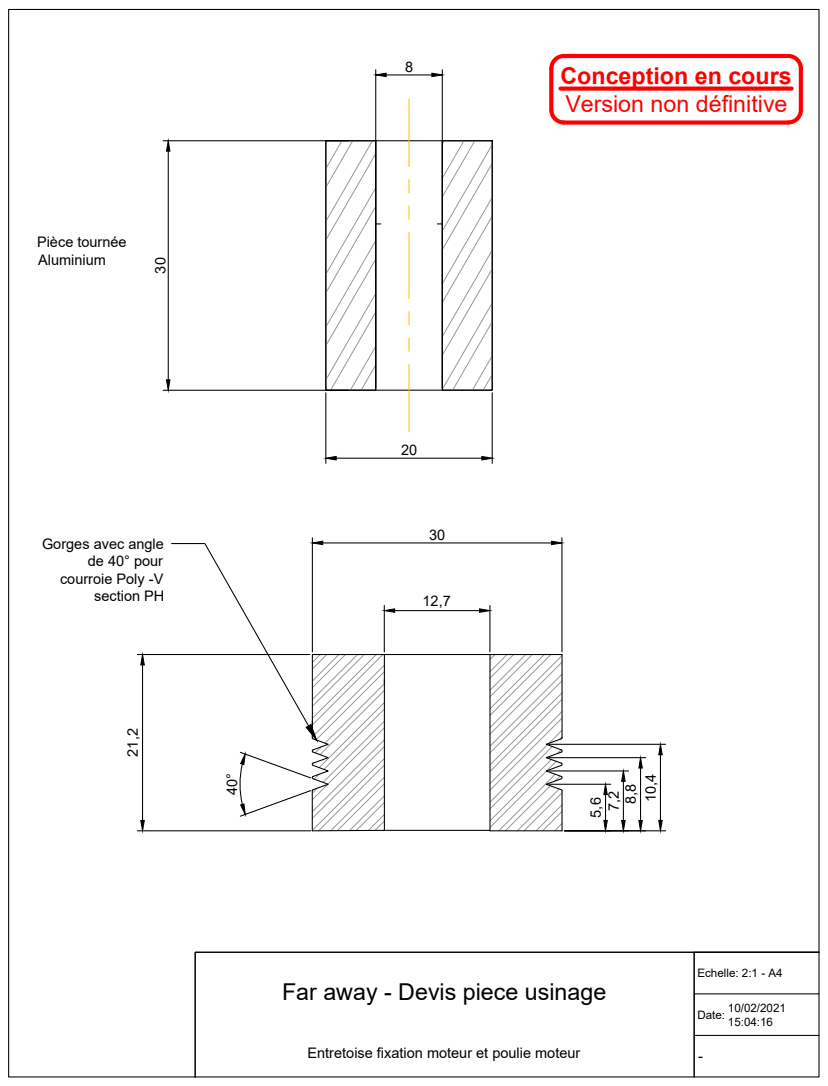
[picture p38: page 2]
Echelle: 2:1 - A4; Pièce tournée; de 40° pour courroie Poly -V section PH

Conception en cours
Version non définitive

Gorges avec angle

- Far away - Devis piece usinage

Entretoise fixation moteur et poulie moteur
