Hemisphere-Project/FarAway/PCB/Faraway_PCB/Faraway_PCB.kicad_pcb

## KiCad design PCB/Faraway_PCB/Faraway_PCB.kicad_pcb (2021-04-19)

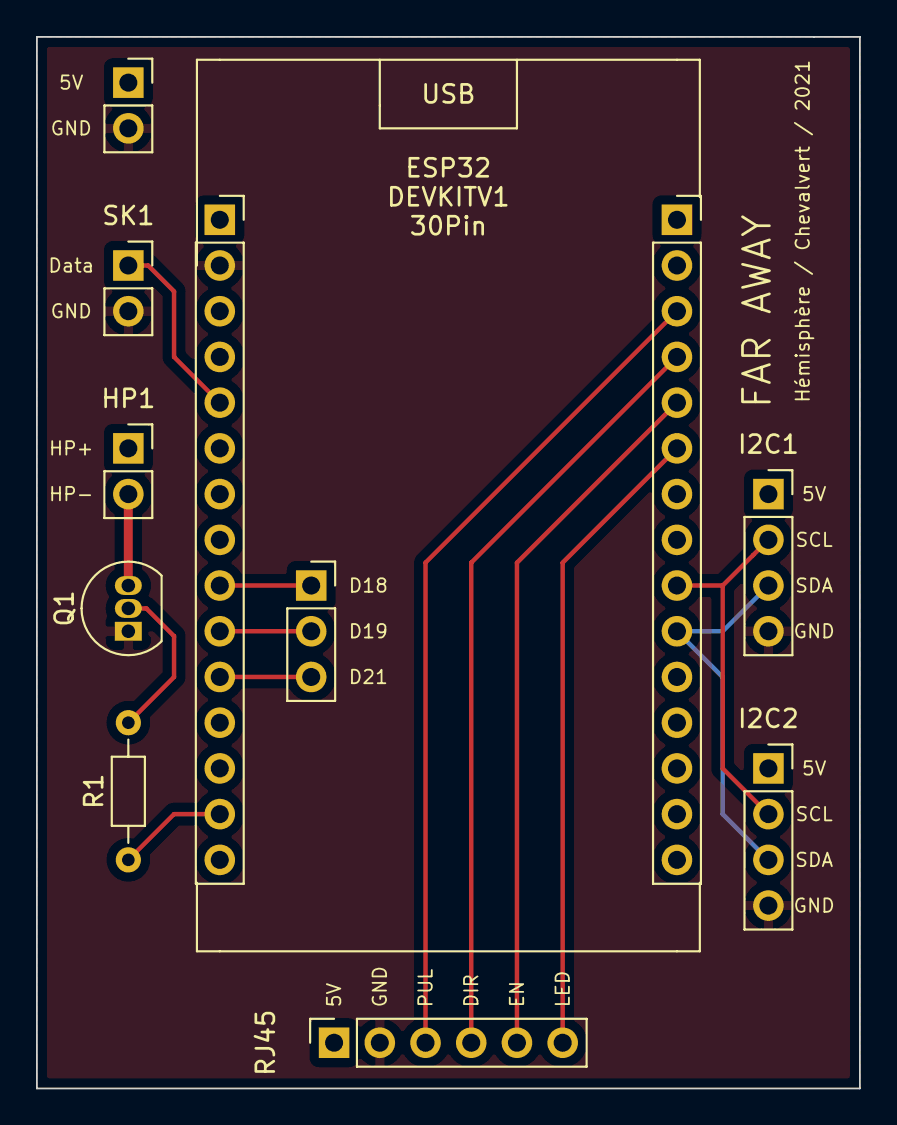
[picture p39: board Faraway_PCB.kicad_pcb from above]

Board: 2 copper layers, 45.7 x 58.4 mm, 11 parts (0 on the bottom side), 15 nets.

Parts:
5V_BONUS1: Conn_01x02_Female; PinSocket_1x02_P2.54mm_Vertical
HP1: Conn_01x02_Female; PinSocket_1x02_P2.54mm_Vertical
I2C1, I2C2: Conn_01x04_Female; PinSocket_1x04_P2.54mm_Vertical
J1: ESP32_DevKitV1_30PIN_Left; PinSocket_1x15_P2.54mm_Vertical
J2: ESP32_DevKitV1_30PIN_Right; PinSocket_1x15_P2.54mm_Vertical
Q1: PN2222A; TO-92_Inline
R1: 1k; R_Axial_DIN0204_L3.6mm_D1.6mm_P7.62mm_Horizontal
RJ45_INPUT1: Conn_01x06_Female; PinSocket_1x06_P2.54mm_Vertical
SK1: Conn_01x02_Female; PinSocket_1x02_P2.54mm_Vertical
SPARE_PINS1: Conn_01x03_Female; PinSocket_1x03_P2.54mm_Vertical

Connections:
+5V: 5V_BONUS1.1, HP1.1, I2C1.1, I2C2.1, J2.1, RJ45_INPUT1.1
AUDIO: J1.14, R1.1
DIR: J2.4, RJ45_INPUT1.4
EN: J2.5, RJ45_INPUT1.5
GND: 5V_BONUS1.2, I2C1.4, I2C2.4, J1.2, Q1.1, RJ45_INPUT1.2, SK1.2
LED: J2.6, RJ45_INPUT1.6
unnamed: HP1.2, Q1.3
unnamed: J1.9, SPARE_PINS1.1
unnamed: J1.10, SPARE_PINS1.2
unnamed: J1.11, SPARE_PINS1.3
unnamed: Q1.2, R1.2
PUL: J2.3, RJ45_INPUT1.3
SCL: I2C1.2, I2C2.2, J2.9
SDA: I2C1.3, I2C2.3, J2.10
SK: J1.5, SK1.1
