Hemisphere-Project/FarAway/Arduino/Full-ESP32-Final/stepper.ino

#include "Arduino.h"

int pulPin = 13;
int dirPin = 12;
int enablePin = 14;

int stepsPerRevolution = 25600*2;

States state = STOP;
unsigned long lastRunAt = 0;

float targetRun = 1.2;
bool enableState = false;

int speed; 
int accel;
int decel; 

unsigned long accu_trig;

void stepper_setup(float accelFactor) 
{
    // set the speed and acceleration rates for the stepper motor
    speed = stepsPerRevolution*0.14;                //*0.14;

    accel = accelFactor*stepsPerRevolution;                 
    if(k32->system->id() == 6) accel = 0.035*stepsPerRevolution;  // DIRTY PATCH 

    decel = 0.015*stepsPerRevolution/targetRun;       //0.15*speed/targetRun;

    // set enable Pin
    pinMode(enablePin, OUTPUT);
    digitalWrite(enablePin, enableState);
    
    stepper_enable(false);

    // connect and configure the stepper motor to its IO pins
    stepper.connectToPins(pulPin, dirPin);
    stepper.setStepsPerRevolution(stepsPerRevolution);


    // Reach destination Callback
    stepper.registerTargetPositionReachedCallback([](long position){
        xTaskCreate(stepper_offTask, "state_off", 2000, NULL, 1, NULL);
    });

    // Start the stepper instance as a service in the "background" as a separate task
    // and the OS of the ESP will take care of invoking the processMovement() task regularily so you can do whatever you want in the loop function
    stepper.startAsService();
}

void stepper_breaker()
{
    // if (enableState) {
    //     stepper_enable(false);
    //     stepper.setTargetPositionToStop();
    // }
    stepper_enable(false);
    if (stepper.isStartedAsService()) stepper.stopService();
}

void stepper_offTask(void* param)
{
    if (state == MOVE || state == FREE) {
        stepper_slowrun();
        while(stepper_accumulate()) delay(10);
    }

    stepper_slowrun();
    

    vTaskDelete( NULL );
}


bool stepper_kick()
{
    // Ready to start
    if (state == SLOW) {
        stepper_enable(true);
        stepper.setSpeedInStepsPerSecond(speed);
        stepper.setAccelerationInStepsPerSecondPerSecond(accel);
        stepper.setDecelerationInStepsPerSecondPerSecond(decel);
        stepper.setTargetPositionRelativeInRevolutions(targetRun);
        targetRun *= -1;
        state = MOVE;
        lastRunAt = millis();
        return true;
    }
    return false;
}

void stepper_freerun()
{
    state = FREE;
    stepper_enable(false);
}

bool stepper_accumulate()
{
    if (state != ACCU) accu_trig = millis();
    state = ACCU;
    return (millis()-accu_trig < 1000);
}

void stepper_slowrun()
{
    state = SLOW;

    stepper.setSpeedInStepsPerSecond(speed * (0.9+random(30)/100) / 12);
    stepper.setAccelerationInStepsPerSecondPerSecond(accel/10);
    stepper.setDecelerationInStepsPerSecondPerSecond(accel/10);

    float target = targetRun*random(5,7)/abs(targetRun);
    stepper.setTargetPositionRelativeInRevolutions(target);
    stepper_enable(true);
}


void stepper_enable(bool doEnable) 
{
    enableState = doEnable;
    digitalWrite(enablePin, !enableState);
} 

States stepper_state() {
    return state;
}

bool stepper_watchdog(int timeoutSeconds) {
    if (timeoutSeconds > 0)
        if ((millis() - lastRunAt) > 1000*timeoutSeconds) return false;
    return true;
}
