Hemisphere-Project/FarAway/(commit log)

2021-01-27 Lidar tests
    [partitions.csv]
2021-01-28 Create Far away - Recherche initale.dwg
    [Far away - Recherche initale.dwg]
2021-02-03 3D v1 ok
    [20210111-faraway.3dm, 20210111-faraway.dwg, Entretoise fixation moteur.3dm, Entretoise fixation moteur.dwg, Motedis Profile 30x30 B-Type slot 8.stp, Platine fixation mat.3dm, Platine fixation mat.dxf, Platine fixation moteur.3dm]
2021-02-03 motor nema dimensions
    [20210111-faraway.dwg]
2021-02-15 plan v1.1
    [FarAway - v1.1.dwg]
2021-03-10 motor ok & ota
2021-03-10 proto atom
    [partitions.csv]
2021-03-10 Full test with K32-lib lite
    [partitions.csv]
2021-03-11 rgbw power test
    [Boites.3dm]
2021-03-17 Dev multiple
    [partition.csv]
2021-03-18 v1.4 - new platine + goussets
    [Platine Lidar Solo.3dm, Platine Lidar Solo.dxf, Platine Lidar.3dm]
2021-03-31 cleanup proto
    [partition.csv, partitions.csv]
2021-04-02 laser ok
    [Boites.3dm, Gousset.3dm, Gousset.dxf, Platine Fixation Mat.3dm, Platine Fixation Mat.dxf, Platine Fixation Moteur.3dm, Platine Fixation Moteur.dxf, Platine Jonction Pivot 1.3dm]
2021-04-06 laser update
    [Gousset.3dm, Gousset.dxf, Platine Fixation Mat.3dm, Platine Fixation Mat.dxf]
2021-04-08 pcb start
    [Entretoise fixation moteur.3dm, Entretoise fixation moteur.dwg, Faraway_PCB.kicad_pcb, Faraway_PCB.sch, Poulie Pivot.3dm, Poulie Pivot.dwg, Poulie moteur.3dm, Poulie moteur.dwg]
2021-04-08 new exports
    [Gousset.3dm, Gousset.dwg, Gousset.dxf, Gousset.stp, Platine Fixation Mat.3dm, Platine Fixation Mat.dwg, Platine Fixation Mat.dxf, Platine Fixation Mat.stp]
2021-04-09 pcb ok
    [Faraway_PCB.kicad_pcb, Faraway_PCB.sch]
2021-04-09 pcb gbr
    [Faraway_PCB-B_Cu.gbr, Faraway_PCB-B_Mask.gbr, Faraway_PCB-B_SilkS.gbr, Faraway_PCB-Edge_Cuts.gbr, Faraway_PCB-F_Cu.gbr, Faraway_PCB-F_Mask.gbr, Faraway_PCB-F_SilkS.gbr, Faraway_PCB.drl]
2021-04-13 Create Far away - Plan.dwg
    Ajout plan de coupe
    [Far away - Plan.dwg]
2021-04-13 update plan _ prod OK
    [Far away - Plan.dwg, Far away - Recherche initale.dwg]
2021-04-16 plan v2
    [Platine Lidar & vis.3dm, Platine Lidar.3dm, Platine Lidar.dxf]
2021-04-19 ESP32 version PCB
2021-05-20 update plans
    [Boitier Driver.3dm, Boitier avant.3dm, Boitier avant.dxf, Far away - Recherche initale.dwg, Motedis Profile 30x30 B-Type slot 8.stp, Platine Fixation Mat.3dm, Platine Fixation Mat.dxf, Platine Fixation Moteur.3dm]
2021-05-27 perçages
    [Boitier avant.3dm, Boitier avant.dxf]
2022-01-28 remove hello_world
    [partition.csv]
2022-01-28 anim led loader
2022-10-17 CleanUP and change WDT instead of ESP.Reboot
    [Full-ESP32-Final.ino, K32_anim.h, K32_light.h, K32_wifi.cpp, anim_leds.h, stepper.ino]
2025-10-23 14: fix blink (not efficient -> need booster !)
    [partitions.csv]
2025-10-27 spiffs format / remove iram
    [partitions.csv]
